Felix7635/BA-Dokumentation/Abbildungen.tex

% !TEX root = BA-Bauer.tex
\newpage
\addcontentsline{toc}{section}{Abbildungsverzeichnis}
\renewcommand{\listfigurename}{Abbildungsverzeichnis}
\listoffigures
