Felix7635/BA-Dokumentation/Hardware.tex

% !TEX root = BA-Bauer

\newpage
\section{Hardware}
In den folgenden Kapiteln wird auf die in dieser Arbeit verwendete Hardware eingegangen. Zunächst wird das grundlegende Pinzip der Schaltung erläutert. Daraufhin werden die Bestandteile bzw. Module im Einzelnen näher erläutert und deren Funktionsweise und Funktion in der Gesamtschaltung erklärt. Abschließend wird erläutert, wie die abstrakte Schaltung in ein Platinendesign überführt und wie diese in einem Gehäuse plaziert wird. Die Datenblätter der Hardwarekomponenten befinden sich im Anhang \ref{CD-Anhang}.
\input{Hardware/Schaltungsprinzip}
\input{Hardware/STM32F446ZE}
\input{Hardware/Treiberchip}
\input{Hardware/Encoder}
\input{Hardware/LCD}
\input{Hardware/LED}
\input{Hardware/Spannungsversorgung}
\input{Hardware/EAGLE}
\input{Hardware/Platinendesign}
\input{Hardware/Gehäusedesign}
%Formaterung überprüfen: Einige Bilder stehen nicht am richtigen Platz (durch Seitenumbruch)
