Felix7635/BA-Dokumentation/Hardware/Encoder.tex

% !TEX root = BA-Bauer

\subsection{Encoder}
\label{sec:Encoder}
Für die Benutzereingaben sind Taster und vor allem ein Encoder wichtig. Taster ermöglichen eine zeitlich präzise Eingabe, wohingegen ein Encoder viele Eingaben in kurzer Zeit ermöglicht. Möchte ein Benutzer eine Aufnahmezeit von 55 Sekunden einstellen, so müsste er 55 Mal einen Taster betätigen, mit einem Encoder reichen wenige Umdrehungen dafür aus. In diesem Kapitel wird auf das Funktionsprinzip und die Beschaltung des verwendeten Encoders eingegangen.\\
%Formulierung: Raster bei den Umdrehung ->24
Ein Encoder besteht im einfachsten Sinne aus zwei Schaltern, wie Abbildung \ref{fig:Encoder-Schaltung} zeigt. 
\begin{figure}[h]
	\begin{center}
		
		\caption{Encoder Schaltung \cite{EncoderMN}}
		\label{fig:Encoder-Schaltung}
	\end{center}
\end{figure}
Die Schalter sind auf der einen Seite intern miteinander verbunden (\textit{Terminal C}) und werden auf das 0\,V Potential geschaltet. Die andere Seite der Schalter wird direkt über \textit{Terminal A} und \textit{Terminal B} nach außen geführt. 
%Jeweils ein exerner 10\,k$\Omega$ Pull-Up-Widerstand (R1 und R3) zieht die Ausgänge auf die Betriebsspannug von 5\,V. Ist der Schalter geöffnet, so fließt kein Strom und folglich fällt keine Spannung am Pull-Up-Widerstand ab. Am entsprechenden Terminal können 5\,V gegenüber der Masse gemessen werden. Ist der Schalter geschlossen so fällt die gesamte Spannung am Widerstand ab und am entsprechenden Terminal liegt nun Masse-Potential an. 
Beide Terminals werden mit jeweils einem 10\,k$\Omega$ Pull-Up-Widerstand ($R1$ und $R2$) auf die Betriebsspannung von 5\,V gezogen. Gleichzeitig wird der Strom, der fließt wenn ein Schalter geschlossen ist, begrenzt. Der Hersteller des Encoders empfiehlt das Beschalten des Encoders mit zwei CR-Tiefpassfiltern, um hochfrequente Schaltvorgänge zu filtern. Bei einem Schaltvorgang können die Kontakte des Schalters mechanisch schwingen (Prellen) und dadurch mehrfach hintereinander öffnen und schließen \cite[S. 67]{TechInfo}, wodurch mehrfache Eingaben getätigt werden, obwohl der Encoder nur um einen Schritt gedreht wurde. Die Signale des Encoders werden an Punkt A und B in Abbildung \ref{fig:Encoder-Schaltung} entnommen und über zwei Leiterbahnen zum MCU geführt. Ist ein Schalter geöffnet, so wird die Kapazität des CR-Filters geladen und die an ihm abfallende Spannung erhöht sich bis zur Betriebsspannung von 5\,V. Wird der Schalter nun geschlossen, so entlädt sich der Kondensator in Richtung des entsprechenden Terminals. Die Spannung an der Kapazität sinkt bis zum 0\,V-Potential. Fängt ein Schalter an zu schwingen, reicht die Zeit zum Laden bzw. Entladen der Kapazität nicht aus, um eine Pegeländerung zu erzielen. 
\begin{figure}[h]
	
	\caption{Encoder-Signal bei Drehung im Uhrzeigersinn}
	\label{fig:Encoder-signal}
\end{figure}
Wenn der Encoder gedreht wird, schließen und öffnen die internen Schalter versetzt zueinander. Abbildung \ref{fig:Encoder-signal} zeigt die ausgehenden Signale \textit{A} und \textit{B} im zeitlichen Verlauf bei einer gleichmäßigen Rotationsgeschwindigkeit. Durch den versetzten Rhythmus der beiden Schalter kann die Drehrichtung bestimmt werden, indem eines der beiden Signale betrachtet wird, in diesem Beispiel Signal \textit{A}. Ändert sich der Zustand des Signals von \textit{high} auf \textit{low}, kann zunächst bestimmt werden, dass eine Drehbewegung stattgefunden hat. Ist nun der Pegel des anderen Signals \textit{high}, so handelt es sich um eine gegen den Uhrzeigersinn drehende Bewegung. Ist das Signal \textit{low}, so handelt es sich um eine mit dem Uhrzeigersinn drehende Bewegung. Die einzelnen Schritte der Schalter sind haptisch für den Benutzer wahrnehmbar. Jeweils an den Stellen, an denen sich die Pegel beider $Terminals$ im high-Zustand befinden, rastet der Drehregler leicht ein. Dadurch wird sichergestellt, dass sich die Signale des Encoders während der Nichtbenutzung in einem stabilen Zustand befinden. Zudem ergibt sich daraus eine zusätzliche Rückmeldung an den Benutzer während der Eingabe.\\
%-Bewusst gegen Druckknopf entschieden, da zweiter Bestätigungsknopf zur Verwirrung des Benutzers führen kann\\
