Felix7635/BA-Dokumentation/GegenstandundZiel.tex

% !TEX root = BA-Bauer

\newpage
\section{Ziel der Arbeit}
\label{sec:Ziel}
In dieser Arbeit werden die in der vorangegangenen Praxisprojektarbeit erarbeiteten Funktionsprinzipien für die Aufnahme und Wiedergabe von DMX-Daten mit einem Mikrocontroller weiterentwickelt und in ein für den Endbenutzer ausgerichtetes Gerät implementiert. Ziel dabei ist die Entwicklung und Herstellung eines Prototypen eines DMX-Aufnahme- und -Wiedergabegerätes. Die Entwicklung ist auf das zukünftige Erlangen der Marktreife ausgerichtet. Zusätzlich zu den Inhalten der Praxisprojektarbeit wird eine umfassende Benutzerschnittstelle entwickelt. Diese ermöglicht dem Benutzer die Bedienung des Geräts ohne spezielle Vorkenntnisse. Konkret werden Taster und Drehgeber für die Eingaben des Benutzers, sowie ein Display und LEDs für Rückmeldungen an den Benutzer verwendet. Durch die Zunahme an Funktionalität und der Anzahl der Komponenten wird außerdem die elektrische Schaltung der Praxisprojektarbeit dementsprechend erweitert und an bereits vorhandenen Stellen optimiert. Für die erweiterte Schaltung wird eine Platine entwickelt, hergestellt und bestückt. Zudem wird ein passendes, kompaktes Gehäuse für die Platine gestaltet und hergestellt.\\
Für die neu hinzugekommene Benutzerschnittstelle sind nicht nur die Komponenten wichtig, sondern auch die Software, die sie steuert. Dafür wird entsprechender Programmcode entwickelt, der dem Benutzer sinnvolle und auswertbare Rückmeldungen gibt und ihm eine intuitive Bedienung des Gerätes ermöglicht. Der Benutzer soll außerdem die Möglichkeit haben, gewisse Einstellungen vorzunehmen um die Funktion des Gerätes auf die eigenen Bedürfnisse anzupassen. Ein besonderes Augenmerk liegt auf der Optimierung der Aufnahme, Wiedergabe und Speicherung der DMX-Daten. Auch hier sollen dem Benutzer möglichst viele Freiheiten eingeräumt werden. Die in der Praxisprojektarbeit erarbeiteten Grundlagen werden dafür verwendet, erweitert und optimiert. Zudem werden die Optimierungsvorschläge der Praxisprojektarbeit berücksichtigt und zum Teil umgesetzt. Für die Entwicklung des Gerätes sind folgende Haupt- und Nebenanforderungen definiert.\\
\newline
\textbf{Hauptanforderungen:}\\
- Möglichkeit mehrere Aufnahmen anzulegen\\
- Einstellbare Aufnahmezeit\\
- Aufname eines DMX-Stroms und einzelner DMX-Datenpakete\\
- Benutzerschnittstelle mit Display und Menüführung\\
- Maßgeschneidertes Platinendesign\\
- Gehäuse\\
- Handliche Größe\\
\newline
\textbf{Nebenanforderungen:}\\
- Intuitive Benutzerschnittstelle\\
- Optisch Ansprechendes Design des Gehäuses\\
- Optimierung des Speicherbedarfs auf der SD-Karte\\
- Möglichkeit die Wiedergabegeschwindigkeit während der aktiven Wiedergabe zu ändern\\
