Felix7635/BA-Dokumentation/Gender.tex

% !TEX root = BA-Bauer.tex
\newpage
\noindent\begin{minipage}[c][.99\textheight][c]{\textwidth}
	\centering
	\begin{minipage}{.65\linewidth}
		%\centering
		\textbf{Gender Erklärung}\\
		\newline
		%\vspace{.5cm}
		Aus Gründen der besseren Lesbarkeit wird in dieser Bachelor-abschlussarbeit das generische Maskulin verwendet. Dabei sind weibliche und anderweitige Identitäten des Geschlechts ausdrücklich gleichermaßen gemeint.
	\end{minipage}
\end{minipage}
