Felix7635/BA-Dokumentation/BA-Bauer.tex

\documentclass[12p, a4paper]{article}

\usepackage[headsepline, footsepline]{scrlayer-scrpage}
\usepackage[hidelinks]{hyperref}

\pagestyle{scrheadings}
\ihead{Bachelorabschlussarbeit}
\ohead{\headmark}
\automark{section}
\ifoot{Felix Bauer}
\ofoot{\pagemark}
\setlength{\tabcolsep}{10pt}
\renewcommand{\arraystretch}{1.5}

\usepackage{listings}
\lstset{numbers = left, numberstyle = \tiny, numbersep = 5pt, language = C, keywordstyle = \color{blue}, stringstyle = \color{teal}, commentstyle = \color{gray}, morecomment = [l][\color{orange}]{\#}, caption={\protect\filename@parse{\lstname}\protect\filename@base\\.\protect\filename@ext},
basicstyle=\sffamily}
\renewcommand{\lstlistingname}{Codeausschnitt}
\usepackage{pdfpages}
\usepackage[ngerman]{babel}
\usepackage[utf8]{inputenc}
\usepackage[top = 25mm, bottom = 20mm, left = 25mm, right = 25mm]{geometry}
\usepackage[onehalfspacing]{setspace}
\usepackage{graphicx}
\graphicspath{{./images/}}
\usepackage{acronym}

\begin{document}
	\input{Titelblatt}
	\input{Selbstständigkeitserklärung}
	\input{Gender}
	\input{Inhaltsverzeichnis}
	\input{Abkürzungsverzeichnis}
	\input{Einleitung}
	\input{GegenstandundZiel}
	\input{Hardware}
	\input{Software}
	\input{Zusammenfassung}
	\input{Danksagung}
	\input{Literatur}
	\input{Abbildungen}
	\input{Codeausschnitt}
	\input{Anhang}

\end{document}
