Felix7635/BA-Dokumentation/Abkürzungsverzeichnis.tex

% !TEX root = BA-Bauer.tex
\newpage
\section*{Abkürzungsverzeichnis}
\addcontentsline{toc}{section}{Abkürzungsverzeichnis}
\begin{acronym}[main]
	\acro{CAD}[CAD]{Computer Aided Design}
	\acro{CCR}[CCR]{Capture Compare Register}
	\acro{DCP}[DCP]{Dedicated Charging Port}
	\acro{DR}[DR]{Data Register}
	\acro{DMX}[DMX]{Digital Multiplexing}
	\acro{EDA}[EDA]{Electronic Design Automation}
	\acro{FAT}[FAT]{File Allocation Table}
	\acro{FATFS}[FATFS]{FAT- Filesystem}
	\acro{HAL}[HAL]{Hardware Abstraction Layer}
	\acro{HSE}[HSE]{High Speed External}
	\acro{HSI}[HSI]{High Speed Internal}
	\acro{LCD}[LCD]{Liquid-Crystal-Display}
	\acro{LED}[LED]{Light Emitting Diode}
	\acro{LDO}[LDO]{Linear Dropout}
	\acro{MCU}[MCU]{Microcontroller Unit}
	\acro{PLL}[PLL]{Phase Locked Loop}
	\acro{SD}[SD]{Secure Digital}
	\acro{SMT}[SMT]{Surface Mount Technology}
	\acro{SR}[SR]{Status Register}
	\acro{SWD}[SWD]{Serial Wire Debug}
	\acro{THT}[THT]{Through Hole Technology}
	\acro{UI}[UI]{User Interface}
	\acro{USB}[USB]{Universal Serial Bus}
\end{acronym}
