Felix7635/BA-Dokumentation/Entwicklungsschritte.tex

% !TEX root = BA-Bauer

\newpage
\section{(Entwicklungsschritte)}

-Grundlegendes Konzept (Weiterentwicklung der BPA)\\
-Schaltung und Komponentensuche\\
-Boarddesign\\
-Prototyfertigung\\
-Bestellung (Platine und Komponenten)\\
-Während Lieferung Softwaredesign\\
-Einzelne Komponenten zum laufen kriegen\\
-Gehäusedesign\\
