Felix7635/BA-Dokumentation/Titelblatt.tex

% !TEX root=BA-Bauer.tex

\begin{titlepage}
	\begin{center}
		\Huge
		\vspace*{2cm}
		\textbf{Entwicklung eines Aufnahme- und Wiedergabegerätes für DMX-Daten}
		
		\Large
		\vspace{2cm}
		Bachelorabschlussarbeit\\
		\vspace{.5cm}
		von\\
		\vspace{.5cm}
		Felix Bauer\\
		\vspace{1cm}
		Im Studiengang B.Eng Elektrotechnik/Informationstechnik\\ mit Schwerpunkt Mess- und Automatisierungstechnik\\
		\vspace{.5cm}
		an der HAWK Hochschule für angewandte Wissenschaft und Kunst\\ Hildesheim/Holzminden/Göttingen\\ Fakultät Ingenieurwissenschaften und Gesundheit in Göttingen\\
		\vspace{1.5cm}
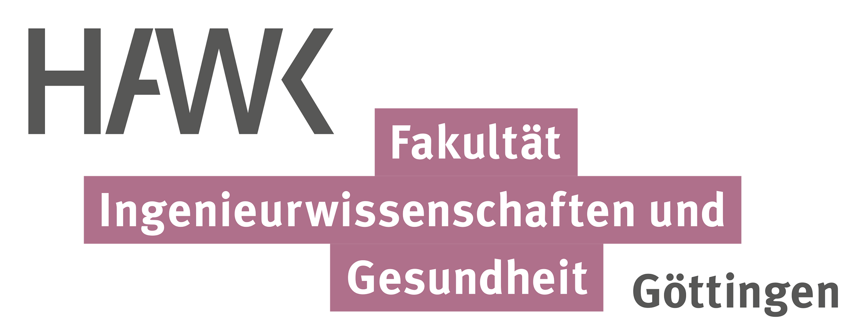
[picture p1: images/HAWK-Logo.png]
		\\
		\vspace{1.5cm}
		Erstprüfer: Prof. Dr. rer. nat. Roman Grothausmann\\
		Zweitprüfer: Dipl.-Ing. Tobias Bürmann\\
		\vspace{.5cm}
		\today
		
		\vfill
	\end{center}
\end{titlepage}
