Felix7635/BA-Dokumentation/Software/Menü.tex

% !TEX root = BA-Bauer.tex
\subsection{Menü}
Die Menüführung ist ein essentieller Bestandteil für die intuitive Bedienbarkeit des Gerätes. Sie muss leicht für den Benutzer zu durchschauen sein und mit den begrenzten Möglichkeiten der C-Programmiersprache programmierbar sein. Für die Menüführung wird ein einfaches Modell aus mehreren Ebenen verwendet. Nachdem das Gerät gestartet und alle Schnittstellen initialisiert sind, wird das Hauptmenü auf dem LCD angezeigt. Der Inhalt des Displays ist in Abbildung \ref{fig:lcdmain} zu sehen. 
\begin{figure}[h]
	\begin{minipage}{.22\linewidth}
		\centering
		
		\caption{LCD-Hauptmenü}
		\label{fig:lcdmain}
	\end{minipage}
	\hfill
	\begin{minipage}{.22\linewidth}
		\centering
		
		\caption{LCD-Aufnahme}
		\label{fig:lcdrec}
	\end{minipage}
	\hfill
	\begin{minipage}{.22\linewidth}
		\centering
		
		\caption{LCD-Wiedergabe}
		\label{fig:lcdplay}
	\end{minipage}
	\hfill
	\begin{minipage}{.22\linewidth}
		\centering
		
		\caption{LCD-Einstellungen}
		\label{fig:lcdset}
	\end{minipage}
\end{figure}
Das Hauptmenü stellt Ebene 0, also die unterste Ebene des Menüs, dar. Zu Beginn ist der erste Menüeintrag gewählt und wird mit einem Pfeil in der ersten Spalte des LCDs markiert. Durch drehen des Encoders kann der Pfeil und damit der ausgewählte Eintrag verändert werden. Eine Drehung im Uhrzeigersinn verschiebt die Auswahl nach unten, eine Drehung gegen den Uhrzeigersinn nach oben. Ist die auszuführende Funktion mithilfe des Pfeils ausgewählt, so kann mit der Betätigung des Bestätigungs-Tasters die nächste Ebene des Menüs erreicht werden. Mithilfe des Zurück-Tasters kann zu der vorherigen Ebene zurückgekehrt werden. Je nach Auswahl werden die Inhalte aus Abbildung \ref{fig:lcdplay}, \ref{fig:lcdrec} oder \ref{fig:lcdset} angezeigt. Da auf dem LCD lediglich vier Zeilen für die Anzeige zur Verfügung stehen, sind Abbildung \ref{fig:lcdrec} und \ref{fig:lcdset} um die nicht sichtbaren Zeilen gestreckt.
In Ebene 3 des Menüs befinden sich die tatsächlichen Funktionen zur Aufnahme und Wiedergabe der DMX-Daten und den Einstellungen. Im Hauptprogramm wird lediglich die Funktion $main\_menu(...)$ aufgerufen, um das Hauptmenü anzuzeigen. Die Zeichenketten, welche über das LCD ausgegeben werden, sind in mehrdimensionalen $char$-Arrays definiert (Codeausschnitt \ref{code:menuarray}).
\lstinputlisting[firstline = 13, firstnumber = 13, lastline = 18, language = C, caption =menu.c: Definition Zeichenkettenarray für LCD-Ausgaben, label = code:menuarray]{/Users/Felix/Documents/CubeMX/BPA-Code/Core/Src/menu.c}
Die erste Dimension des Arrays entspricht der Anzahl der anzuzeigenden Menüelemente, die zweite der Anzahl der zu beschreibenden Spalten des LCDs. Es werden bewusst nur 19 Spalten der verfügbaren 20 mit den Menüelementen beschrieben, da vor jedem Element Platz für den Pfeil freigehalten wird, der die aktuelle Auswahl anzeigt. Um willkürliche Zeichen zu eliminieren, die sich eventuell noch in den nicht beschriebenen Speicherzellen der Arrays befinden, werden die nicht benötigten Zeichen mit Leerzeichen überschrieben. Durch die Verwendung der Zeichenkettenarrays können die Menüeinträge einfach verändert oder erweitert werden. 
\begin{figure}[h!]
	\centering
	
	\caption{Flussdiagramm Hauptmenü}
	\label{fig:flusshauptmenu}
\end{figure}
Abbildung \ref{fig:flusshauptmenu} zeigt den Ablauf der Funktion $main\_menu(...)$. Zunächst werden alle Inhalte vom Display entfernt und die Menüüberschrift ausgegeben. Die globale Variable der Position des Encoders wird auf den Initialwert 0 zurückgesetzt. Daraufhin werden die ersten drei Menüeinträge aus dem Zeichenkettenarray unterhalb der Menüüberschrift ausgegeben (Abbildung \ref{fig:lcdmain}). Der Wert der Encoderposition entspricht der aktuellen Auswahl des Benutzers. Initial gilt der erste Eintrag als ausgewählt. Um nicht bei jedem Durchlauf der Funktion den gesamten Displayinhalt erneut ausgeben zu müssen erfolgt eine Abfrage ob sich die Encoderposition geändert hat. Nur wenn er sich verändert hat, wird der Auswahlpfeil an der entsprechend resultierenden Stelle angezeigt. Ist der Enter-Taster betätigt, wird die nächste entsprechende Menüebene aufgerufen. Welche Menüfunktion aufgerufen wird, wird mithilfe einer $switch-case$-Anweisung der Encoderposition entschieden. 
\newline
Um zu einer vorherigen Menüebene zurückzukehren, müssen die Menüfunktionen durch einen $return$-Befehl oder durch Erreichen des Endes der Funktion beendet werden. Werden die vorherigen Menüebenen in der jeweiligen Funktion durch einen Funktionsaufruf aufgerufen, kommt es zu einem rekursiven Aufruf von Funktionen. Zwangsläufig entstehen daraus Speicherprobleme, da reservierter Speicherplatz durch den Aufruf der Funktionen nicht wieder freigegeben wird. Ist der Speicher voll, so kommt es bei einem nächsten Funktionsaufruf zum Überlauf des Speichers und dadurch zu Fehlfunktionen oder vollständigem Abbruch des Programms.
