Felix7635/BA-Dokumentation/Software/SD.tex

% !TEX root = BA-Bauer.tex

\subsection{SD-Karte (SDIO-Schnittstelle)}

Die von CubeMX generierte Initialisierungs-Funktion der \textit{secure digital input output} (SDIO)-Schnittstelle führt beim Start des Gerätes oft zu Fehlern, wodurch die SD-Karte weder gelesen noch beschrieben werden kann. In der Regel fällt das Programm dann in eine endlose Fehler-Funktion und ein Neustart des Geräts bewirkt keine Änderung des Zustands. Um dieses Problem zu lösen, wird nach den von CubeMX generierten Initialisierungsfunktionen im Hauptprogramm eine weitere Funktion zur Initialisierung der Verbindung mit der SD-Karte aufgerufen. Der wesentliche Inhalt dieser Funktion ist in Codeausschnitt \ref{code:SDinit} zu sehen.
\lstinputlisting[
caption =main.c: SD Initialisierungs-Funktion,
label = code:SDinit,
firstline = 284,
firstnumber = 284,
lastline = 295]
{/Users/Felix/Documents/CubeMX/BPA-Code/Core/Src/main.c}
Um eine SD-Karte verwenden zu können, muss diese als erstes mithilfe der Funktion $f\_mount(...)$ montiert werden. Dabei wird ein Dateisystem ($filesystem$) und ein Pfad ($path$) mit der Hardware verknüpft. Bei diesem Schritt treten in der Regel Fehler auf. Ist der Rückgabewert der Funktion $f\_mount(...)$ nicht $FR\_OK$ werden die Zeilen 285 bis 294 so lange wiederholt, bis die SD-Karte erfolgreich montiert ist, denn ohne ein Speichermedium ist das Gerät in keinerlei Hinsicht sinnvoll verwendbar. Der aktuelle Status der SD-Karte wird als erstes der Variable $sd\_state$ zugewiesen. Befindet sich keine SD-Karte im SD-Kartenslot ($STA\_NODISK$) wird eine entsprechende Meldung über das LCD an den Benutzer gegeben. Ist der Status der SD-Karte $STA\_NOINIT$, so wird das Montieren der SD-Karte zunächst rückgängig gemacht, indem erneut die Funktion $f\_mount(...)$ aufgerufen wird, jedoch wird der Wert 0 als Dateisystem-Übergabeparameter der Funktion übergeben. Daraufhin wird die Variable des Dateisystem mithilfe der $memset(...)$ Funktion mit 0 initialisiert und eine erneute SD-Initialisierung gestartet. Zuletzt wird der Pfad mithilfe der Funktion $SD\_initialize(...)$ erneut initialisiert. Die Schleife startet erneut mit einem weiteren Versuch der Montierung.
\newline
Codeausschnitt \ref{code:SDread} zeigt einen beispielhaften Ablauf eines Lesevorgangs von der SD-Karte. Der Vorgang startet mit dem Öffnen einer Datei ($File$), zu sehen in Zeile 1009. Mit dem Parameter $FA\_READ$ wird der Funktion mitgeteilt, dass die Datei gelesen werden soll. Der Parameter $FA\_OPEN\_ALWAYS$ sorgt dafür, dass die Datei geöffnet wird wenn sie existiert, ansonsten wird eine Datei mit dem entsprechenden Dateinamen ($hdmx->DMXInfoFile\_name$) erstellt. In dem gezeigten Beispiel wird von der Existenz der Datei ausgegangen. Mit dem Parameter $FA\_OPEN\_EXISTING$ wird eine bereits existierende Datei geöffnet. Falls sie nicht existiert, gibt die Funktion einen entsprechenden Fehlercode zurück. Soll eine Datei beschrieben werden, muss der Parameter $FA\_WRITE$ übergeben werden.
\lstinputlisting[
caption =DMX.c: Beispiel Lesevorgang der SD-karte,
label = code:SDread,
firstline = 1009,
firstnumber = 1009,
lastline = 1016]
{/Users/Felix/Documents/CubeMX/BPA-Code/Core/Src/DMX.c}
Nachdem die Datei geöffnet ist, werden Daten mit der Funktion $f\_read(...)$ aus der Datei gelesen. Der erste Übergabeparameter ($File$) ist das Objekt der Datei, aus der gelesen werden soll. Darauf folgt die Adresse der Zielvariable, in der die gelesenen Daten gespeichert werden sollen. An dritter Stelle steht die Anzahl der zu lesenden Bytes. Der letzte Übergabeparameter ist die Adresse einer Variable, in der die Anzahl der tatsächlich gelesenen Bytes gespeichert wird. Durch einen nachfolgenden Vergleich der Soll- und Ist-Anzahl der gelesenen Bytes können Fehler, die beim Lesevorgang aufgetreten sind, identifiziert werden \cite{FATFS}. Nachdem alle Lesevorgänge beendet sind, muss die Datei mit der Funktion $f\_close(...)$ wieder geschlossen werden, da die Anzahl der gleichzeitig geöffneten Dateien begrenzt ist, um Speicherprobleme auszuschließen.\\
\newline
\textbf{Optimierungsmöglichkeiten}\\
In der aktuellen Version des Programms wird der 1-Bit-Modus der SDIO-Schnittstelle verwendet. Von den vier vorhandenen Datenleitungen wird nur eine in diesem Modus verwendet. Auf der Platine sind zusätzliche Leiterbahnen für die Verwendung eines 4-Bit-Modus vorhanden. Scheinbar befinden sich Fehler in der SDIO-Bibliothek in CubeMX, wodurch der Montierungs-Vorgang nicht erfolgreich durchgeführt werden kann. Durch die Verwendung des 4-Bit-Modus könnte die Lese- und Schreibgeschwindigkeit der SD-Karte im bestmöglichen Fall vervierfacht werden und trägt damit zur Stabilität während der Aufnahme und Wiedergabe bei.
