Felix7635/BA-Dokumentation/Software/Aufnahmefunktion.tex

% !TEX root = BA-Bauer.tex

\subsection{Aufnahmefunktionen}
\label{sec:recfunctions}
Für die Aufnahme von DMX-Daten stehen insgesamt vier verschiedene Aufnahmemodi zur Verfügung, welche jeweils eine Aufnahmefunktion bilden. Der erste Aufnahmemodus ist der Standard-Modus, bei dem vorab die Dauer der Aufnahme festgelegt wird. Nach Ablauf der Aufnahmedauer stoppt die Aufnahme und kehrt zum Menü zurück. Der zweite Modus ist der sogenannte $Trigger$-Modus, bei dem zuvor in den Einstellungen ein $Trigger$-Kanal und $Trigger$-Wert festgelegt werden. Ist die Aufnahme gestartet und in den eingehenden DMX-Datenpaketen wird der $Trigger$-Wert des ausgewählten $Trigger$-Kanals überschritten, so startet ab diesem Zeitpunkt die Speicherung der DMX-Daten. Die Aufnahme wird gestoppt, wenn der $Trigger$-Wert wieder unterschritten wird. Dieser Modus ermöglicht das Starten und Stoppen der Aufnahme zu sehr präzisen Zeitpunkten. Vor allem für sich wiederholende Bewegungsabläufe von lichttechnischen Geräten ist diese Funktion äußerst sinnvoll. Ist die Position eines Lichtkegels beispielsweise am Anfang und Ende der Aufnahme identisch, so kann die Aufnahme endlos nacheinander wiedergegeben werden, ohne dass ein Anfang oder Ende der aufgenommenen Sequenz sichtbar ist. Der letzte kontinuierliche Aufnahme-Typ ist die endlose Aufnahme, bei der die Aufnahme ohne die Wahl einer Aufnahmedauer gestartet wird und durch betätigen des Zurück-Tasters gestoppt wird. Dieser Modus richtet sich an Situationen, in denen die Endzeit der Aufnahme beim Aufnahmebeginn nicht festgelegt werden kann. Ein Beispiel für einen Anwendungsfall ist ein Konzert. Zu Beginn des Konzerts kann die Aufnahme gestartet und nach der letzten Zugabe, gestoppt werden. Bei dem letzten Aufnahme-Typ handelt es sich um eine nicht-kontinuierliche Aufnahme der DMX-Daten, die sogenannte $Step$-Aufnahme. Bei diesem Aufnahme-Typ können einzelne Datenpakete des eingehenden DMX-Datenstroms aufgenommen werden. Jedes Datenpaket entspricht einem $Step$ und enthält, im Gegensatz zu den drei anderen Aufnahmemodi, keine Zeitinformationen. Die einzelnen Steps werden bei der Wiedergabe in einem regelmäßigen Zeitabstand, der erst bei der Wiedergabe vom Benutzer festgelegt wird, wiedergegeben. Dieser Modus gibt dem Benutzer die Möglichkeit die DMX-Datenpakete in einer bestimmten Taktung auszugeben und diese beispielsweise an den Takt eines Liedes anzupassen. Zudem wird durch die Speicherung einzelner Datenpakete, im Vergleich zu den anderen Aufnahmemodi, deutlich weniger Speicherplatz auf der SD-Karte benötigt. 
Im Folgenden wird auf das Grundprinzip der Aufnahmefunktionen eingegangen. Ein Flussdiagramm des Standard-Aufnahmemodus befindet sich im Anhang \ref{fluss:recf}.\newline
Die drei Aufnahmemodi der kontinuierlichen Aufnahme, also Standard-, Endlose- und $Trigger$-Aufnahme unterscheiden sich im wesentlichen nur in den Start- bzw. Stoppbedingungen, welche in Tabelle \ref{tab:recstartstop} zusammengefasst sind. Im Standardmodus muss zusätzlich eine Aufnahmezeit festgelegt werden. 
\begin{table}[h]
	\begin{center}
		\caption{Start und Stoppbedingungen der Aufnahmemodi}
		\label{tab:recstartstop}
		\begin{tabular}{l | p{6cm} | p{6cm}}
			Modus & Startbedingung & Stoppbedingung\\
			\hline
			Standard & Bestätigungstaster & Ablauf der Aufnahmezeit\\
			Endlos & Bestätigungstaster & Zurück-Taster\\
			$Trigger$ & $Trigger$-Wert auf $Trigger$-Kanal überschreiten & $Trigger$-Wert auf $Trigger$-Kanal unterschreiten
		\end{tabular}
	\end{center}
\end{table}\newline
\subsubsection{Festlegen der Aufnahmezeit}
Abbildung \ref{lcd:rectime} zeigt die Ausgabe auf dem LCD für die Festlegung der Aufnahmezeit. Die Auswahl der Zeit ist in vier Blöcke für das Einstellen der Stunden, Minuten, Sekunden und Millisekunden aufgeteilt. Mit den Links- und Rechts-Tastern kann der ausgewählte Block, markiert mit dem Zeichen in der untersten Zeile des Displays, verändert werden. 
\begin{figure}[h]
	\begin{center}
		
		\caption{LCD-Ausgabe Aufnahmezeit}
		\label{lcd:rectime}
	\end{center}
\end{figure}
Der Wert des Blocks wird mit einer Drehung des Encoders im Uhrzeigersinn erhöht und gegen den Uhrzeigersinn verringert. Der Millisekunden-Block erhöht bzw. verringert sich immer um 10 Millisekunden. Eine feinere Auflösung im Millisekundenbereich ist nicht sinnvoll, da die DMX-Datenpakete eine Zeitdauer von 22\,ms zur vollständigen Übertragung benötigen. Wird eine Drehbewegung des Encoders registriert, so wird zunächst überprüft ob der vorherige Wert weiter erhöht oder verringert werden kann. Damit wird ausgeschlossen, dass eine Zeit kleiner null gewählt werden kann oder beispielsweise die Anzahl der Minuten größer 59 ist. Ist die Auswahl der Zeit beendet, so muss sie mit dem Bestätigung-Taster bestätigt werden. Die eingegebene Zeit wird dann in Millisekunden umgerechnet und in die entsprechende Variable der Aufnahmezeit geschrieben.\\
\newline
\textbf{Optimierungsmöglichkeiten}\\
Um die Festlegung der Aufnahmezeit noch benutzerfreundlicher zu gestalten, ist es sinnvoll die Begrenzungen der einstellbaren Zeit aufzuheben. Sind zum Beispiel 59\,Sekunden eingestellt und der Wert wird mit einer Drehung des Encoder weiter erhöht, so wäre es sinnvoll die Anzahl der Minuten zu inkrementieren und die Anzahl der Sekunden auf null zurückzusetzen. Das gleiche Prinzip könnte auch in die andere Richtung funktionieren. Außerdem ist bei der Festlegung der Zeit die maximal mögliche Aufnahmedauer nicht berücksichtigt. Der Benutzer hätte also die Möglichkeit eine Aufnahmezeit festzulegen, die technisch aufgrund der maximalen Dateigröße auf der SD-Karte nicht erreicht werden kann. Dieser Fall sollte durch eine entsprechende Abfrage abgefangen werden.
\subsubsection{Festlegen des Dateinamens}
Jede Aufnahme erfordert die Festlegung eines Dateinamens, um eine Auswahl bei der Wiedergabe zu ermöglichen. Der vor der Aufnahme festgelegte Name entspricht dem Dateinamen der Datei auf der SD-Karte und ermöglicht dem Benutzer ausgewählte Aufnahmen auf andere SD-Karten zu übertragen oder Sicherheitskopien anzulegen. Dem Benutzer stehen bei der Festlegung des Namens insgesamt acht Zeichen zur Verfügung. Abbildung \ref{lcd:filename} zeigt die Ausgabe auf dem LCD-Display. Wie bereits im vorherigen Kapitel wird mithilfe der Links- und Rechts-Taster eine Auswahl getroffen, in diesem Fall ein Zeichen des Dateinamens. Durch drehen des Encoders können die Zeichen geändert werden. Verfügbare Zeichen sind alle Buchstaben von A-Z in kleiner und großer Schreibweise, Zahlen von 0-9, sowie ein Leerzeichen und ein Unterstrich.
\begin{figure}[h]
	\begin{center}
		
		\caption{LCD-Ausgabe Dateinamen einstellen}
		\label{lcd:filename}
	\end{center}
\end{figure}
Umgesetzt wird dieser Programmteil mithilfe eines Zeichen-Arrays, dessen Anzahl an Zellen der Länge des Dateinamens entspricht. Die letzten vier Zellen des Arrays werden mit der Dateiendung ($.dmx$) beschrieben. Die Endung ist bei der Auswahl des Namens nicht veränderbar. Die restlichen Zellen des Arrays werden initial mit einem Unterstrich beschrieben und sollen damit dem Benutzer ein veränderbares Zeichen signalisieren. Ein Zeichen besteht aus einem Byte und kann somit 256 Werte annehmen, wobei jeder Wert einem Zeichen entspricht. Wird zum Beispiel der Wert, der einem $a$ entspricht, um 1 inkrementiert, so wird ein $b$ dargestellt. Aufgrund dieses Systems kann der Wert der Position des Encoder unmittelbar als Zeichen dargestellt werden und in die entsprechende Zelle des Arrays geschrieben werden. Eine Veränderung der Encoderposition bewirkt eine Änderung des gerade ausgewählten Zeichens.
\input{Software/DMX-In}
\subsubsection{Speicherung der Aufnahmedaten}
\label{sec:save_data}
Abbildung \ref{fig:DMXDatenformat} zeigt die Reihenfolge, in der die einzelnen Bytes in der Aufnahme-Datei mit der Endung $.dmx$ gespeichert werden. Alle aufgenommenen Datenpakete werden hintereinander in der Datei gespeichert. Begonnen wird mit dem Zeitpunkt, an dem das Datenpaket vollständig empfangen wurde. Alle vier Bytes der 32-Bit Variable werden hintereinander gespeichert. Darauf folgen die eigentlichen DMX-Informationen der einzelnen DMX-Kanäle. Auch diese werden nacheinander gespeichert, beginnend mit dem DMX-Startbyte (Kanal 0). Nach dem letzten Datenbyte des DMX-Datenpaketes befindet sich das Schlusszeichen (NPC) des Datenpaketes. Direkt nach dem Schlusszeichen beginnt das nächste Datenpaket. 
\begin{figure}[h]
	\begin{center}
		
		\caption{DMX-Aufnahmedaten Bytereihenfolge}
		\label{fig:DMXDatenformat}
	\end{center}
\end{figure} Geht man davon aus, dass die DMX-Datenpakete mit der maximal möglichen Frequenz von ca. 44,1\,Hz eingehen, so wird pro Minute ein Speicherplatz von:
\begin{equation}
	44,1\,Hz * 518\,Byte * 60\,s = 1370628\,Byte = 1,37\,MByte
\end{equation} auf der SD-Karte benötigt. Eine SD-Karte mit einer Kapazität von 32\,GByte bietet somit Speicherplatz für ca. 23346 Minuten Aufnahme. Das entspricht einer Aufnahmedauer von etwas über 16\,Tagen. Begrenzender Faktor der maximalen Dauer einer Aufnahme stellt das $FAT$-Dateisystem dar. Es stellt nur 4-Bytes für die Angabe der Dateigröße zur Verfügung und begrenzt damit die maximale Dateigröße auf 4\,GB \cite[s. 128]{BetriebssystemeKompakt}. Eine Datei umfasst demnach maximal $2^{32}\,Byte$. Das entspricht einer maximalen kontinuierlichen Aufnahmedauer von:
\begin{equation}
	tAufnahme_{max} = \frac{2^{32}\,Byte}{518\,Byte * 44,1\,Hz * 60\,\frac{s}{min} * 60\,\frac{min}{h}} = 55,227\,h
\end{equation}
Diese Dauer sollte in den meisten Fällen ausreichend sein und könnte nur erweitert werden, indem ein anderes Dateisystem verwendet wird oder beim Erreichen der maximalen Dateigröße die Speicherung der Daten in einer zweiten Datei fortgeführt wird. 
Zusätzlich zu den DMX-Daten werden generelle Informationen über die Aufnahme in einer separaten Datei mit der Endung $.nfo$ gespeichert. Alle Informationen werden unabhängig vom Aufnahmemodus gespeichert. Darunter befinden sich die Aufnahmedauer, die Anzahl der gespeicherten Datenpakete und das NPC-Byte.\\
\newline
\textbf{Optimierungsmöglichkeiten}\\
Die Datenpakete werden unabhängig vom Informationsgrad gespeichert, was unnötig viel Speicherplatz erfordert. Denkbar ist ein Vergleich des aktuell zu speichernden DMX-Datenpakets mit dem zuvor gespeicherten DMX-Datenpaket. Beinhaltet das zuvor gespeicherte DMX-Datenpaket die selben Informationen wie das aktuelle, so könnte die Speicherung des aktuellen Paketes übersprungen werden, da es keine neuen Informationen enthält. Dieser Vorgang benötigt allerdings Ressourcen um den Vergleich der Datenpakete vorzunehmen. Durch den Vergleich und das eventuelle Wegfallen von Speicherungsvorgängen könnten wiederum Ressourcen eingespart werden.
