Felix7635/BA-Dokumentation/Software.tex

% !TEX root = BA-Bauer
\newpage
\section{Software}
In diesem Kapitel werden die Funktionsweisen der wichtigsten Funktionen der Software erläutert, sowie die Hilfsmittel die zur Erstellung des Programmcodes verwendet werden, vorgestellt. Der vollständige Programmcode, sowie Projektdateien befinden sich im Anhang \ref{CD-Anhang}, sowie als git-repository \cite{git_bpa_code} und \cite{git_lcd} auf github.com.
\input{Software/HAL}
\input{Software/CubeMX}
\input{Software/CubeIDE}
\input{Software/Taster}
\input{Software/Encoder}
\input{Software/DMX-Struktur}
\input{Software/Aufnahmefunktion}
\input{Software/Wiedergabefunktion}
\input{Software/LCD}
\input{Software/SD}
\input{Software/Menü}
\input{Software/Einstellungen}
