Felix7635/BA-Dokumentation/Danksagung.tex

% !TEX root = BA-Bauer.tex
\newpage
\section*{Danksagung}
\addcontentsline{toc}{section}{Danksagung}
An dieser Stelle möchte ich allen danken, die mich im Entwicklungsprozess und der Anfertigung dieser Arbeit unterstützt haben.\\
\newline
Zuerst möchte ich mich bei Herrn Prof. Dr. rer. nat. Roman Grothausmann und Herrn Dipl.-Ing. Tobias Bürmann für die Betreuung meiner Bachelorabschlussarbeit bedanken. Durch Ihren Einsatz ist die Bearbeitung dieses Themas erst möglich geworden. Auch die zahlreichen Meetings haben mir wertvolle Anregungen in Bezug auf die Entwicklung gegeben.\\
\newline
Mein Dank gilt außerdem Herrn Stefan Ludwig und das Kollegium des Labors, die mich bei der Herstellung einer Prototyp-Platine unterstützt haben. Sie haben die Platinenfräse der HAWK an die Grenzen des Machbaren gebracht und mich damit in der Entwicklung einen großen Schritt vorangebracht.\\
\newline
Ich danke Jannik Schulz für die wiederkehrende technische Unterstützung im gesamten Entwicklungsprozess.\\
\newline
Ebenfalls bedanke ich mich bei Isabel Klink und Robert Hut, die mich jederzeit tatkräftig mit ihrer Hilfsbereitschaft und Geduld unterstützt und motiviert haben.\\
\newline
Abschließend möchte ich mich bei den Korrekturlesende Isabel Klink, Jannik Schulz, Marcel Trebing und David Wendel bedanken.\\
\newline
Felix Bauer\\
\newline
\newline
\newline
Göttingen, 14.09.2021
