Felix7635/BA-Dokumentation/Anhang.tex

% !TEX root = BA-Bauer.tex

\newpage
\appendix
\section{Flussdiagramme}
\subsection{Aufnahmefunktion}
\label{fluss:recf}
\begin{figure}[h]
	\begin{center}
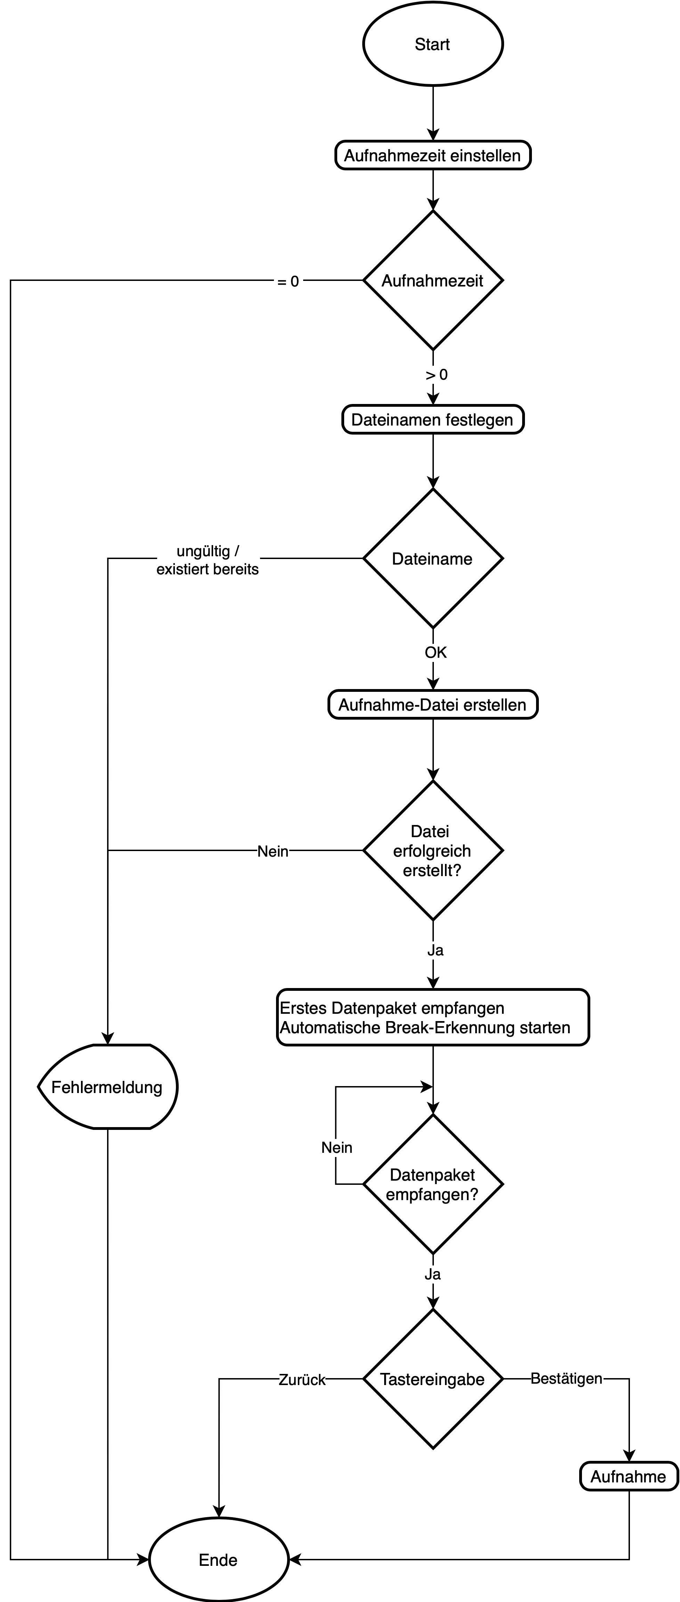
[picture p4: images/Aufnahmefunktion.png]
		
	\end{center}
\end{figure}
\newpage
\subsection{Wiedergabefunktion}
\label{fluss:playf}
\begin{figure}[h]
	\begin{center}
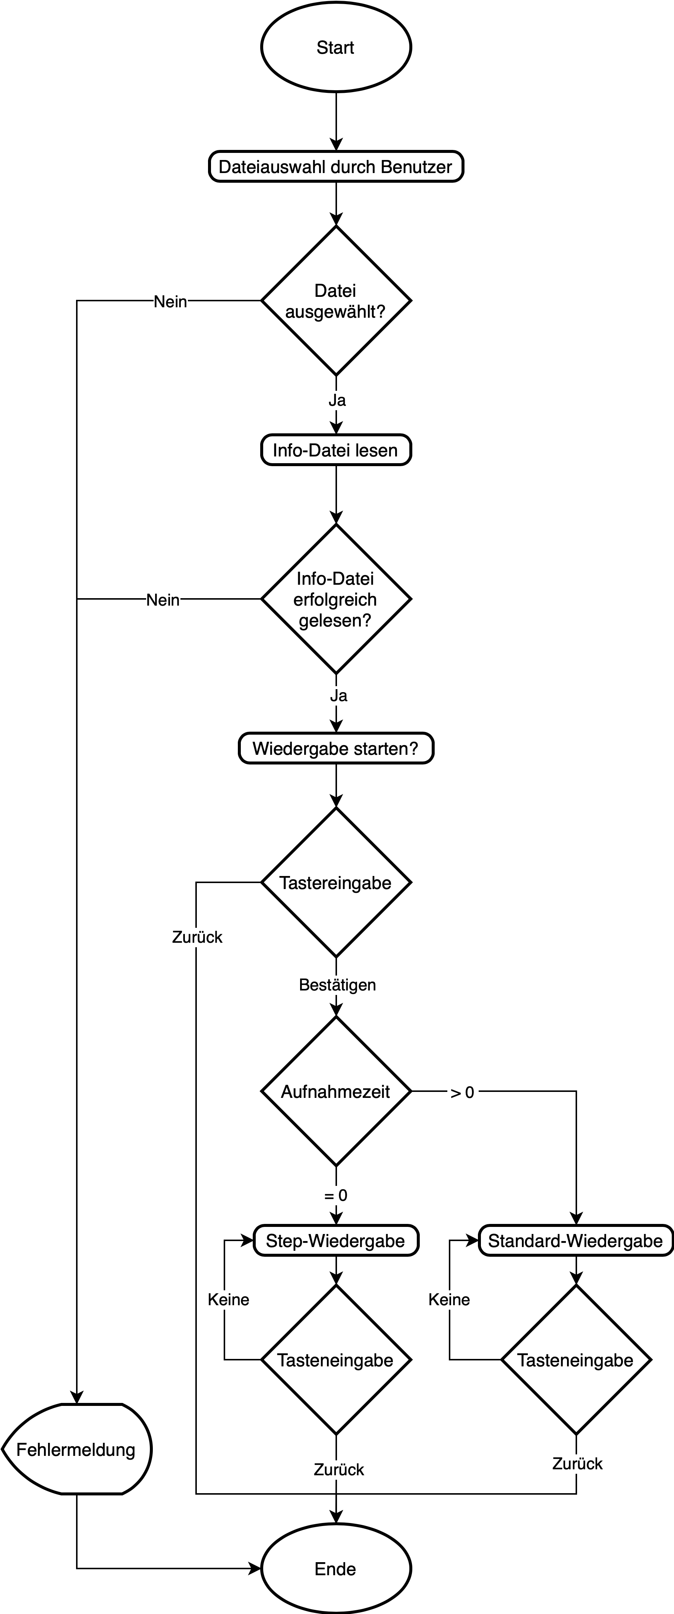
[picture p5: images/Wiedergabefunktion.png]
		
	\end{center}
\end{figure}
\newpage
\subsection{Standard Wiedergabe}
\label{fluss:playconti}
\begin{figure}[h]
	\begin{center}
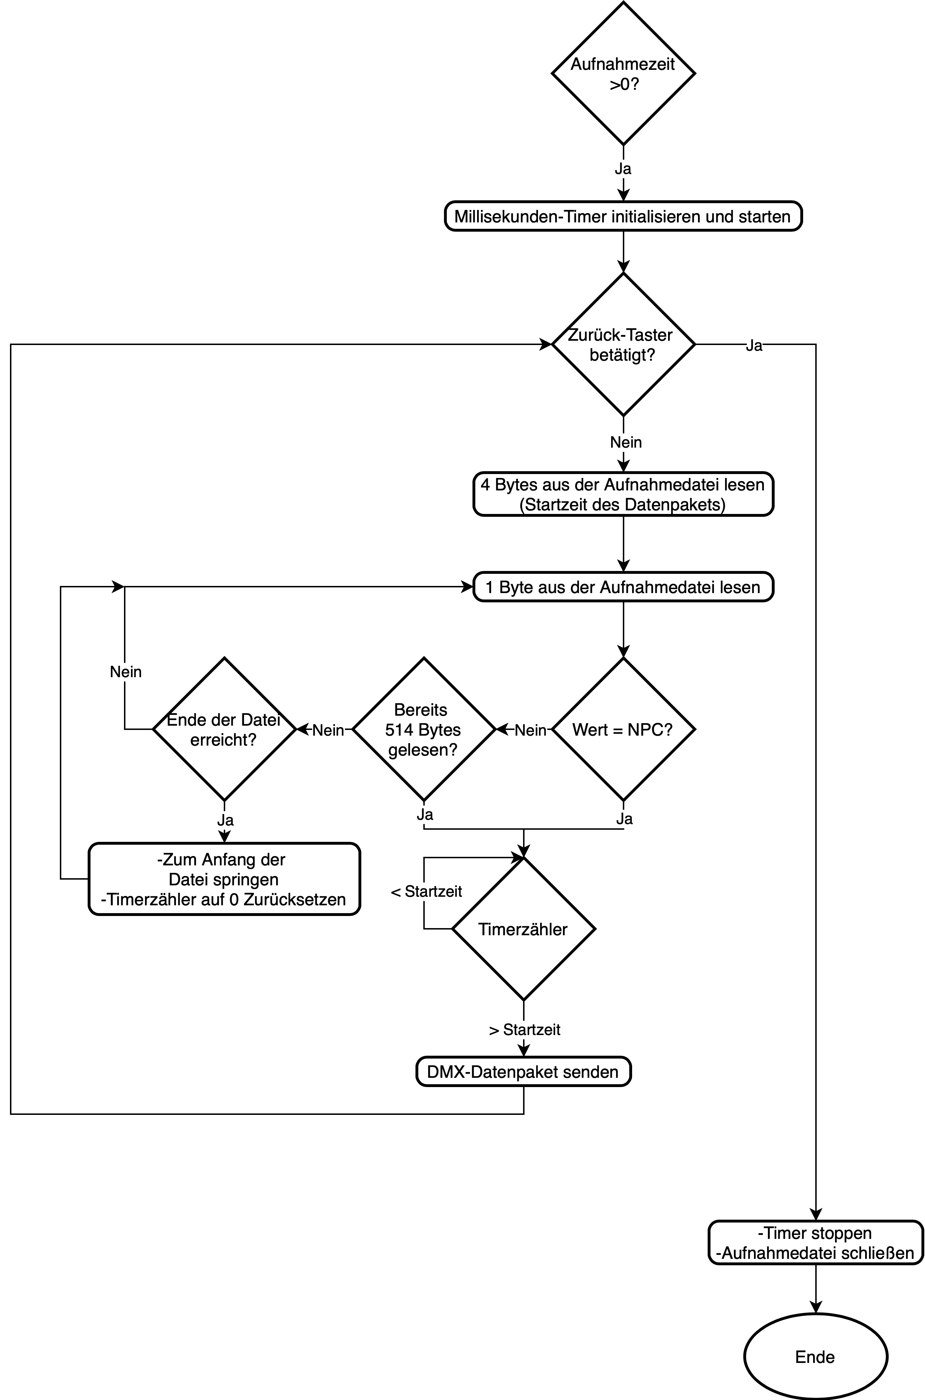
[picture p6: images/Wiedergabe_kontinuierlich.png]
		
	\end{center}
\end{figure}
\newpage
\section{Inhalt CD-ROM}
\label{CD-Anhang}
\begin{figure}[h]
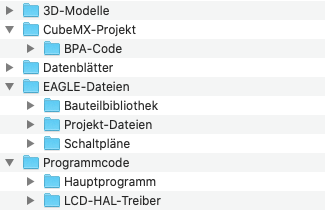
[picture p7: images/CD-Inhalt.png]
	
\end{figure}
