Felix7635/BA-Dokumentation/BA-Bauer.pdf

## Entwicklung eines Aufnahme- und

## Wiedergabeger¨ates fur DMX-Daten ¨

Bachelorabschlussarbeit

von

Felix Bauer

Im Studiengang B.Eng Elektrotechnik/Informationstechnik

mit Schwerpunkt Mess- und Automatisierungstechnik

an der HAWK Hochschule fur angewandte Wissenschaft und Kunst ¨

Hildesheim/Holzminden/G¨ottingen

Fakult¨at Ingenieurwissenschaften und Gesundheit in G¨ottingen

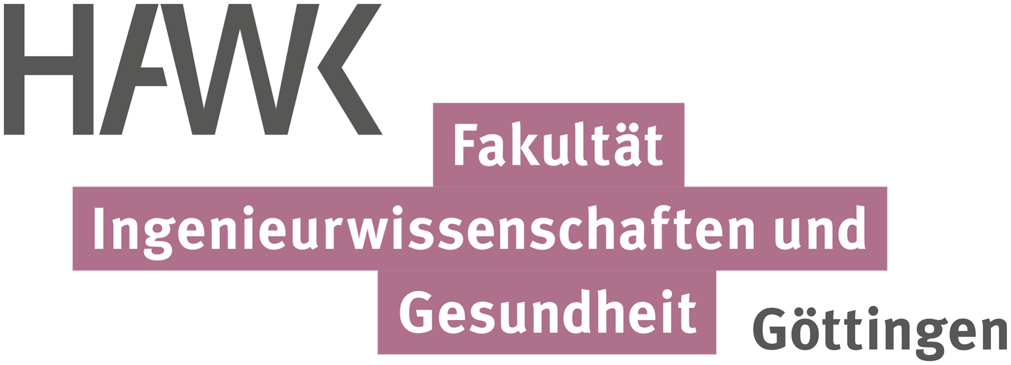
[picture p8: figure]

Erstprufer: Prof. Dr. rer. nat. Roman Grothausmann ¨

Zweitprufer: Dipl.-Ing. Tobias B ¨ | urmann ¨
21. Juni 2021

Selbstständigkeitserklärung

Hiermit erkläre ich, dass ich die vorliegende Abschlussarbeit selbstständig, ohne fremde Hilfe und nur unter Verwendung der angegebenen Literatur angefertigt habe. Alle fremden, öffentlichen Quellen sind als solche kenntlich gemacht. Mir ist bekannt, dass ich für die Quellen Dritter in dieser Arbeit die Nutzungsrechte zur Verwendung in dieser Arbeit benötige. Weiterhin versichere ich, dass diese Abschlussarbeit noch keiner anderen Prüfungskommission vorgelegen hat.

Göttingen, den | Unterschrift

Erklärung zu Nutzungsrechten und Verwertungsrechten

Ich bin hiermit einverstanden,
dass von meiner Abschlussarbeit (ggf. nach Ablauf der Sperre) 1 Vervielfältigungsstück erstellt werden kann, um es der Bibliothek der HAWK zur Verfügung zu stellen und Dritten öffentlich zugänglich zu machen.
Ich erkläre, dass Rechte Dritter der Veröffentlichung nicht entgegenstehen.
Göttingen, den | Unterschrift

Sperrvermerk der Abschlussarbeit

[ ] NEIN*
JA / Dauer der Sperre: | [ ] 3 Jahre* [ ] 5 Jahre*
Göttingen, den | | Unterschrift

* Zutreffendes bitte ankreuzen
- Dadurch räumen Sie der HAWK ein einfaches, zeitlich unbeschränktes, unentgeltliches Nutzungsrecht nach §§ 15 Abs. 2 Nr. 2, 16,17,19a, 31 Abs. 2 UrhG ein.

Inhaltsverzeichnis

1 Einleitung | 3
2 Entwicklungsschritte | 4
3 Hardware | 5
4 Software | 6

### 1 Einleitung

### 2 Entwicklungsschritte

### 3 Hardware

### 3.1 Schaltungsprinzip

### 3.2 ST-Microelectronics STM32F446ZE

### 3.3 Maxim Integrated RS485 Treiberchip

### 3.4 Encoder

### 3.5 LCD

### 4 Software

Literatur

Abbildungen
