Felix7635/BA-Dokumentation/Anhang/EAGLE-Dateien/Schaltpläne/Hauptschaltung.png

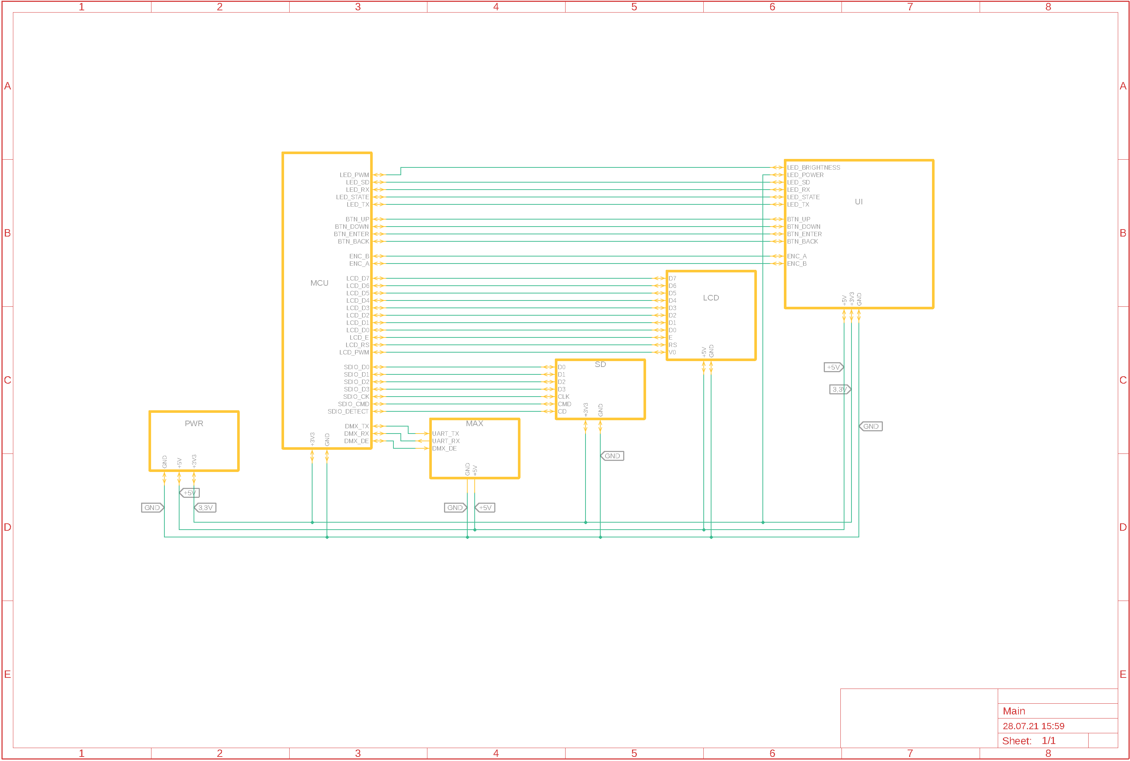
Anhang/EAGLE-Dateien/Schaltpläne/Hauptschaltung.png
