Felix7635/BA-Dokumentation/Anhang/EAGLE-Dateien/Schaltpläne/Modul - F446ZE.png

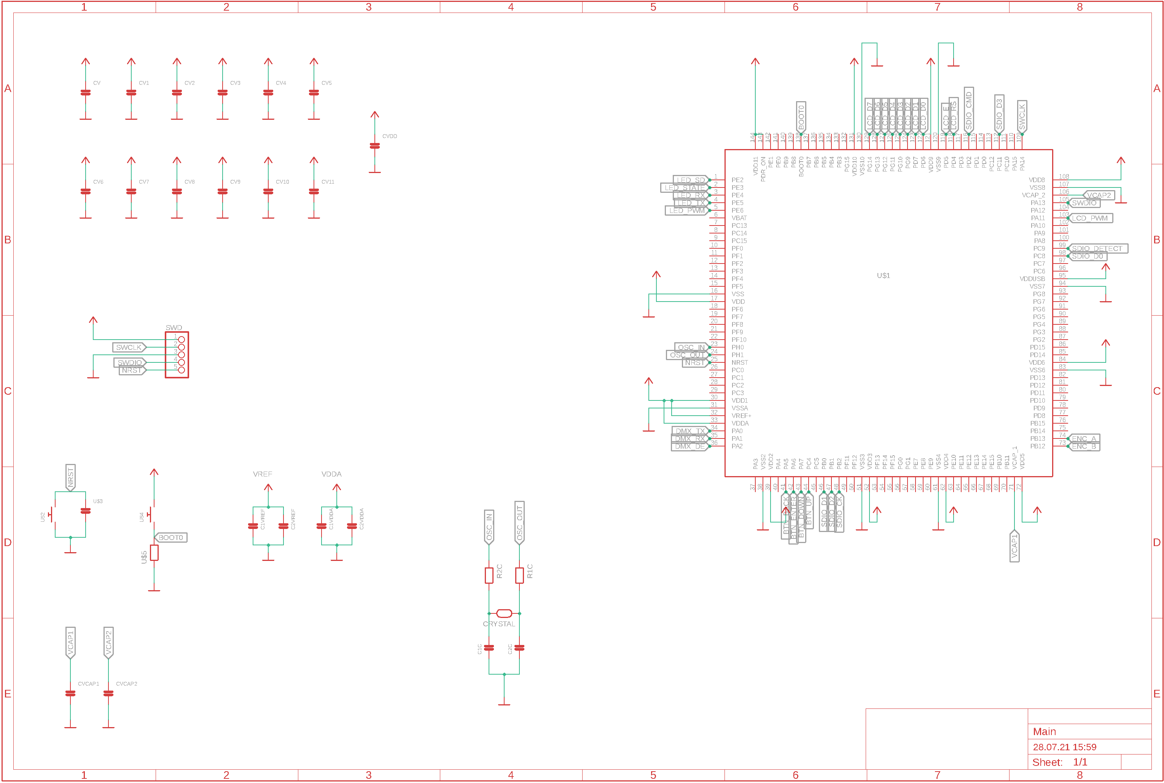
Anhang/EAGLE-Dateien/Schaltpläne/Modul - F446ZE.png
