Felix7635/BA-Dokumentation/Anhang/EAGLE-Dateien/Schaltpläne/Modul - GUI.png

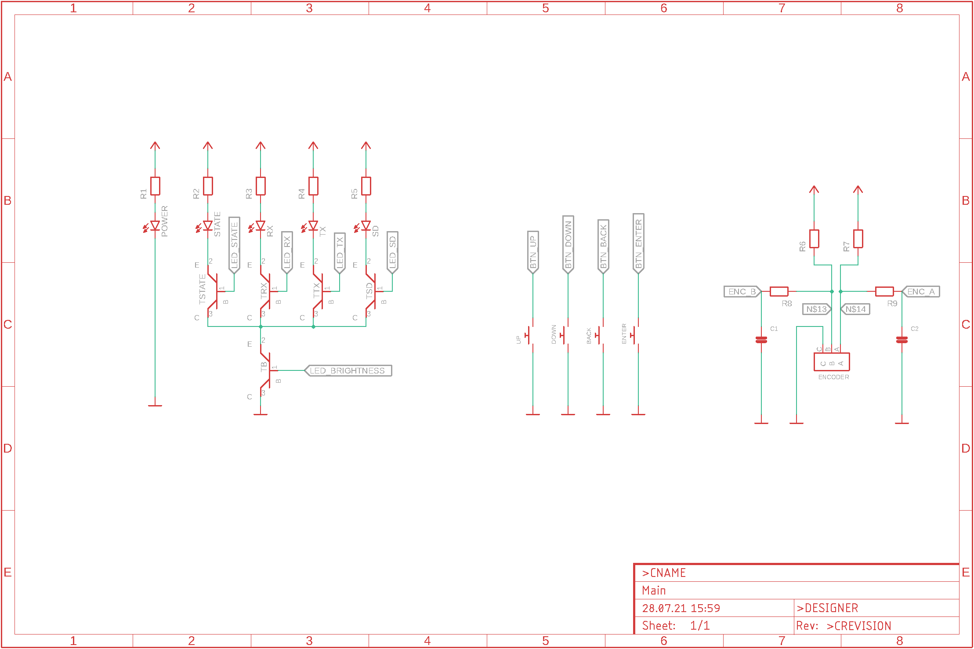
Anhang/EAGLE-Dateien/Schaltpläne/Modul - GUI.png
