Felix7635/BA-Dokumentation/Anhang/EAGLE-Dateien/Schaltpläne/Modul - LCD.png

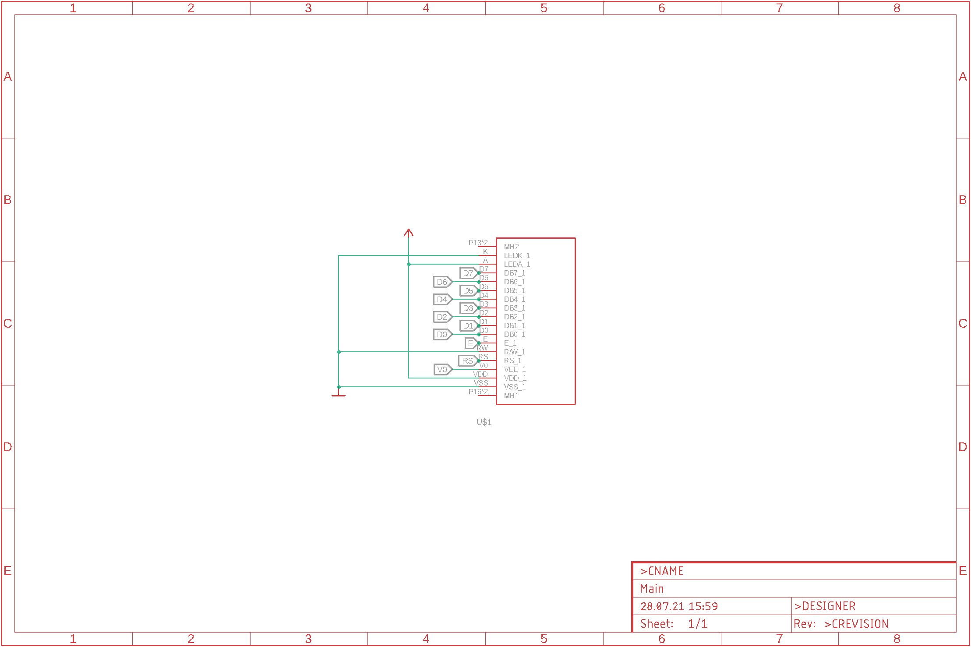
Anhang/EAGLE-Dateien/Schaltpläne/Modul - LCD.png
