Felix7635/BA-Dokumentation/Anhang/EAGLE-Dateien/Schaltpläne/Modul - Power.png

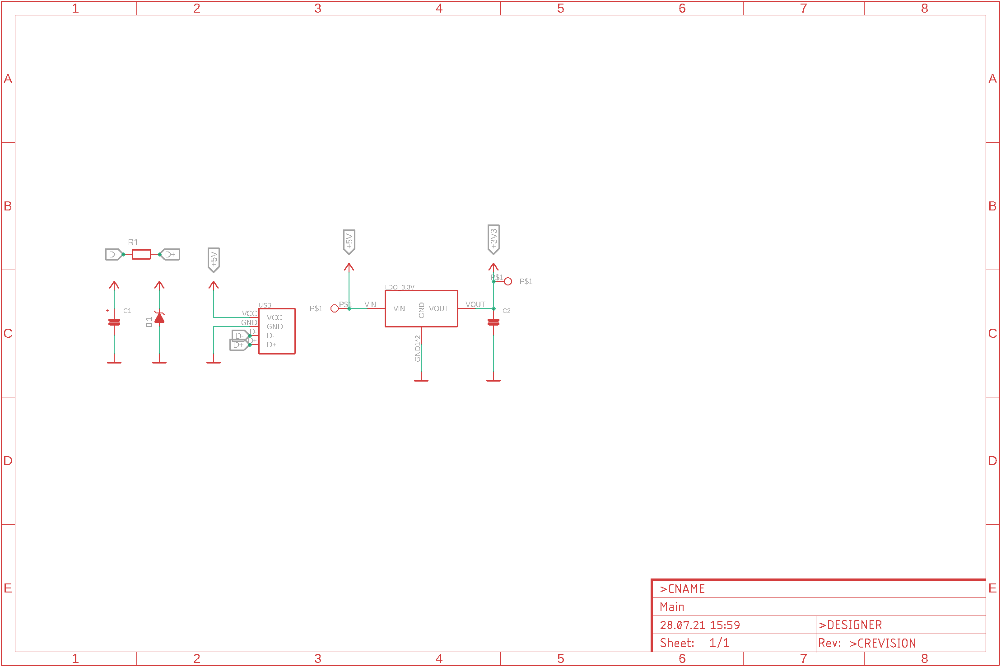
Anhang/EAGLE-Dateien/Schaltpläne/Modul - Power.png
