Felix7635/BA-Dokumentation/Anhang/EAGLE-Dateien/Schaltpläne/Modul - RS485.png

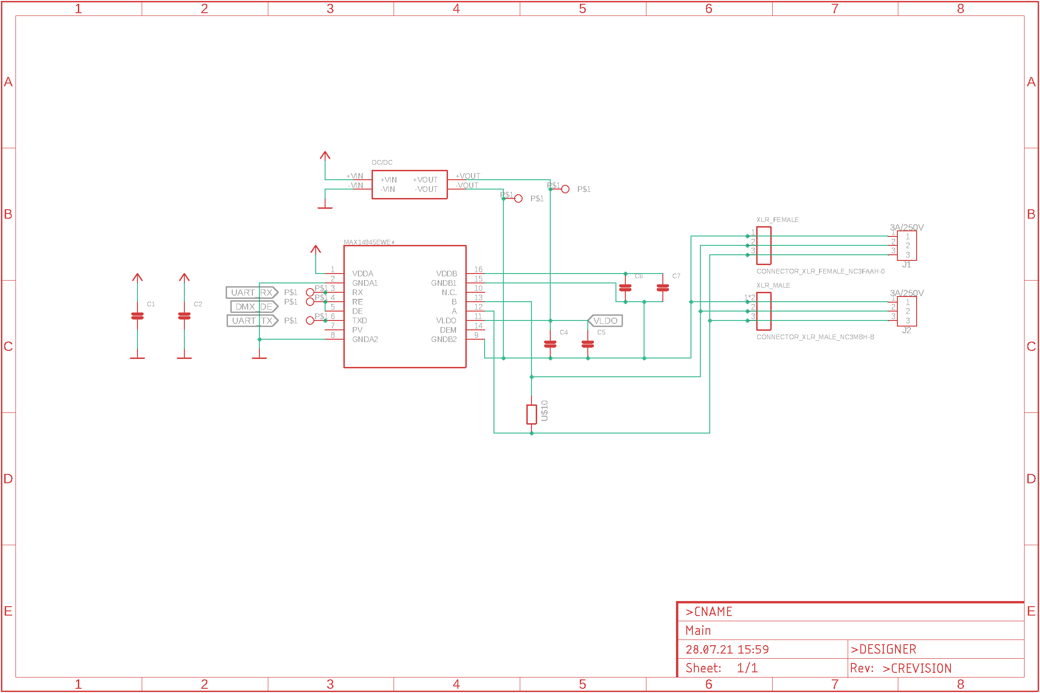
Anhang/EAGLE-Dateien/Schaltpläne/Modul - RS485.png
