Felix7635/BA-Dokumentation/Anhang/EAGLE-Dateien/Schaltpläne/Modul - SD.png

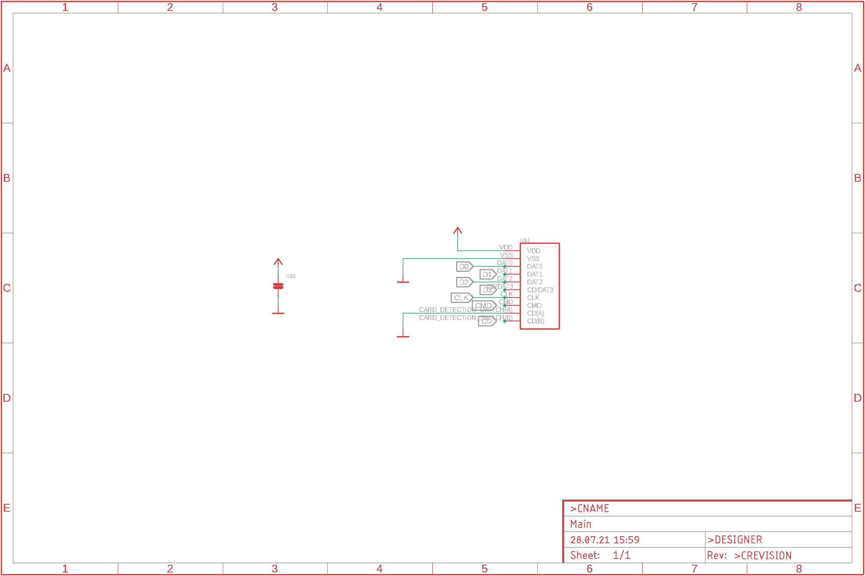
Anhang/EAGLE-Dateien/Schaltpläne/Modul - SD.png
