Felix7635/BA-Dokumentation/images/CubeMX-clock-mark.png

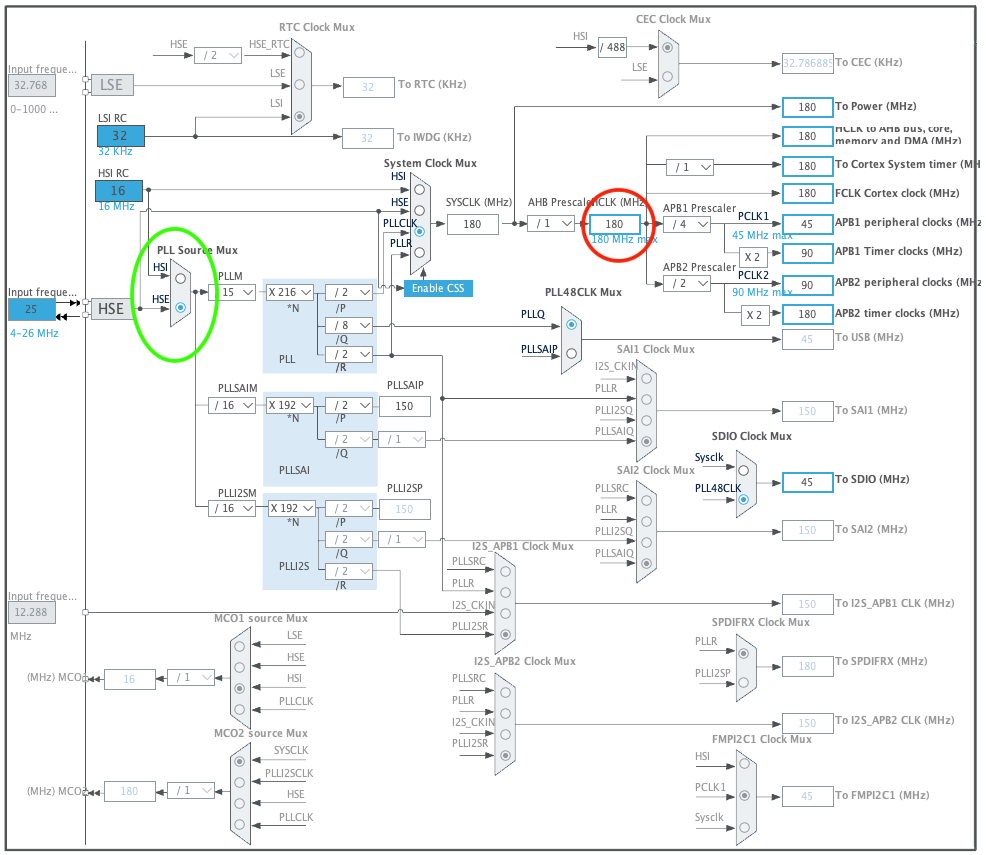
images/CubeMX-clock-mark.png
