Felix7635/BA-Dokumentation/images/CubeMX-timerconfig.png

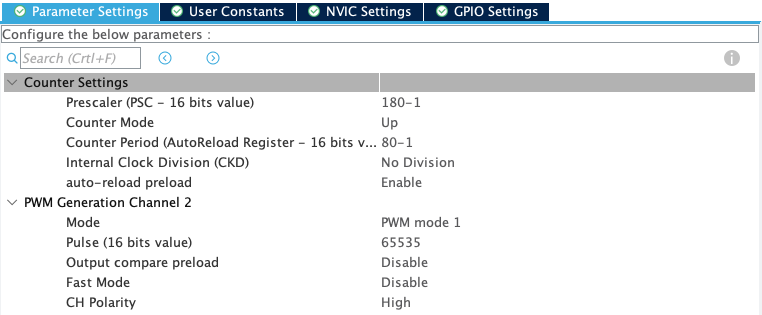
images/CubeMX-timerconfig.png
