Felix7635/BA-Dokumentation/images/Encoder-Schaltung-Eagle.png

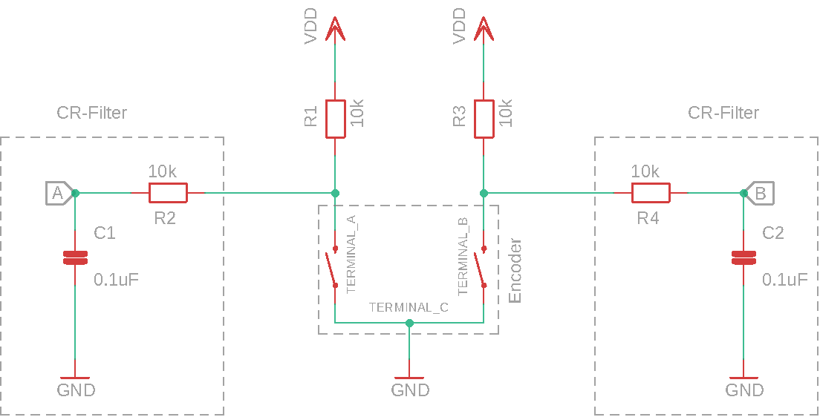
images/Encoder-Schaltung-Eagle.png
