Felix7635/BA-Dokumentation/images/Encoder-Schaltung.png

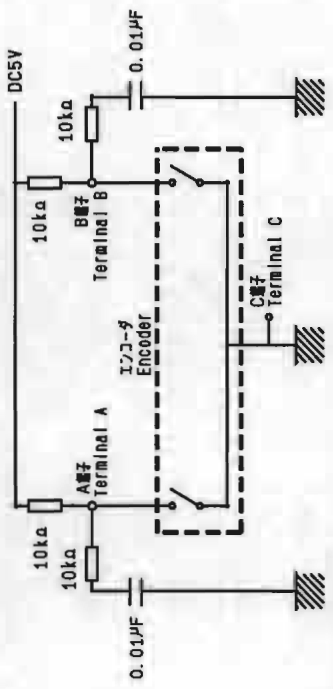
images/Encoder-Schaltung.png
