Felix7635/BA-Dokumentation/images/Encoder-signal.png

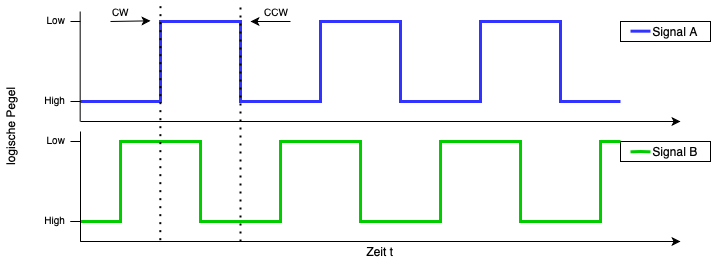
images/Encoder-signal.png
