Felix7635/BA-Dokumentation/images/Housing-back.png

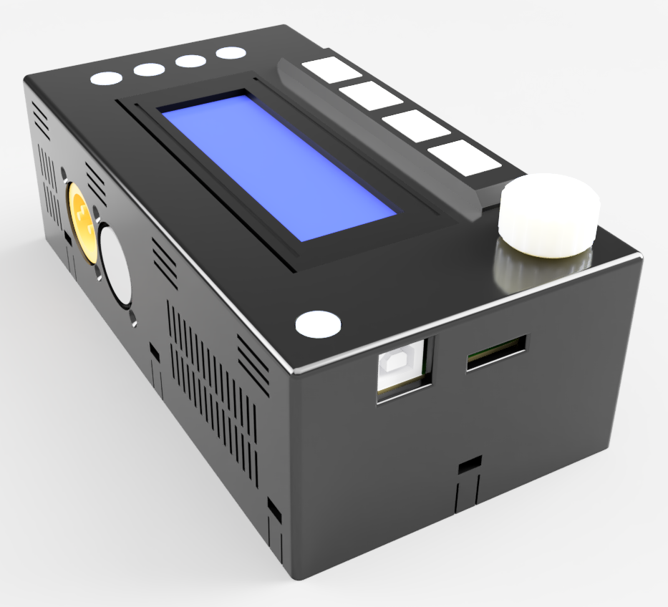
images/Housing-back.png
