Felix7635/BA-Dokumentation/images/Housing-front.png

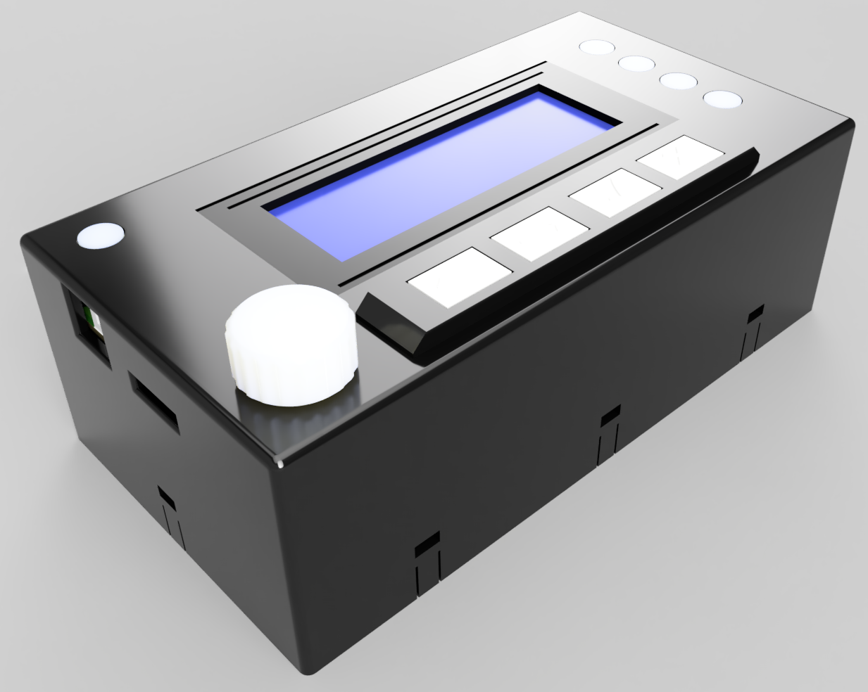
images/Housing-front.png
