Felix7635/BA-Dokumentation/images/Housing-Schnitt-Befestigung2-mark.png

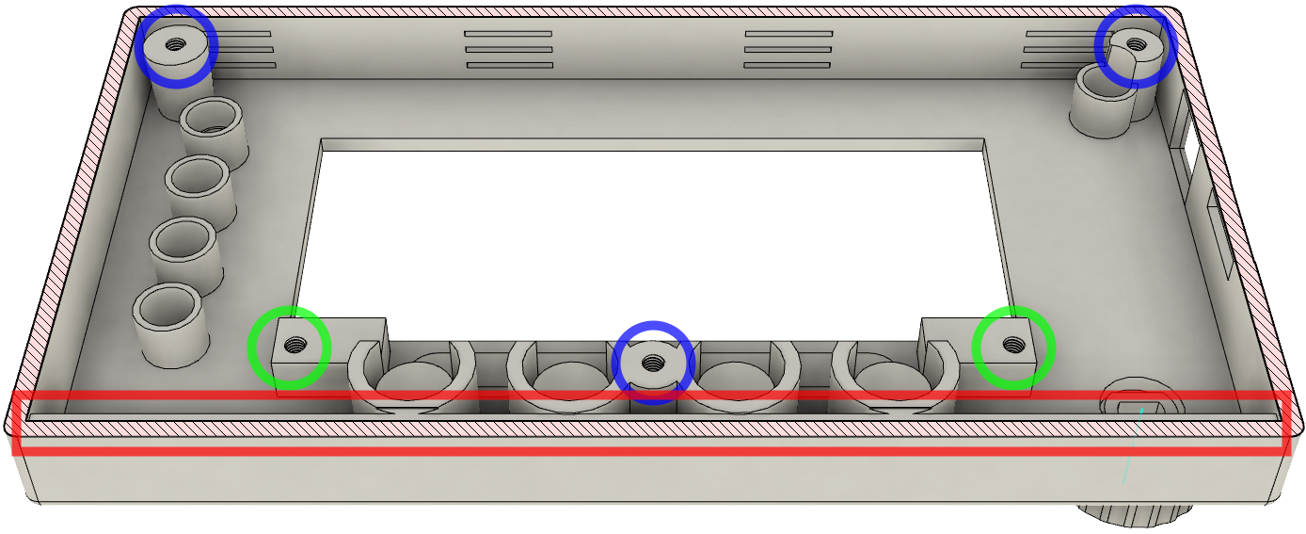
images/Housing-Schnitt-Befestigung2-mark.png
