Felix7635/BA-Dokumentation/images/Housing-Schnitt-Befestigung2.png

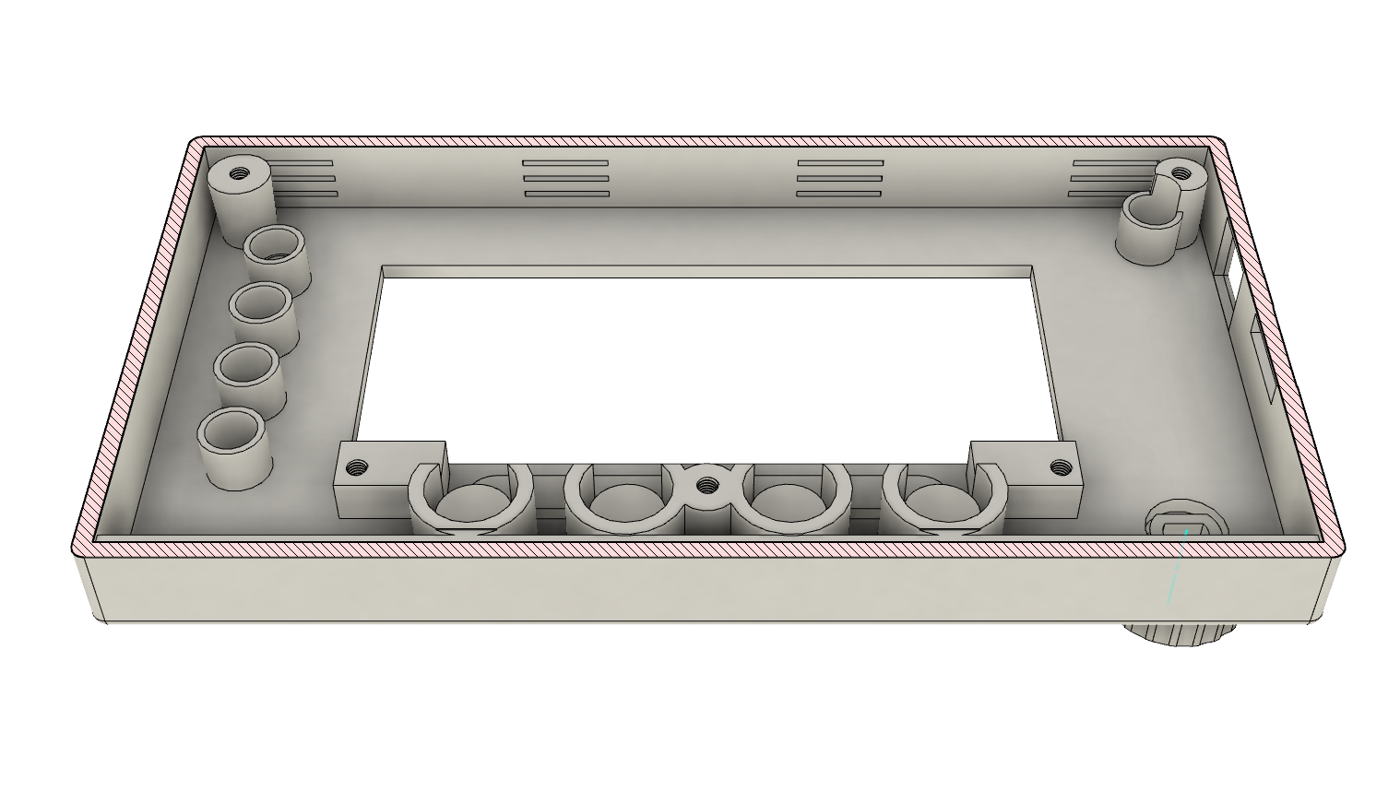
images/Housing-Schnitt-Befestigung2.png
