Felix7635/BA-Dokumentation/images/Housing-Schnitt-Befestigung-mark.png

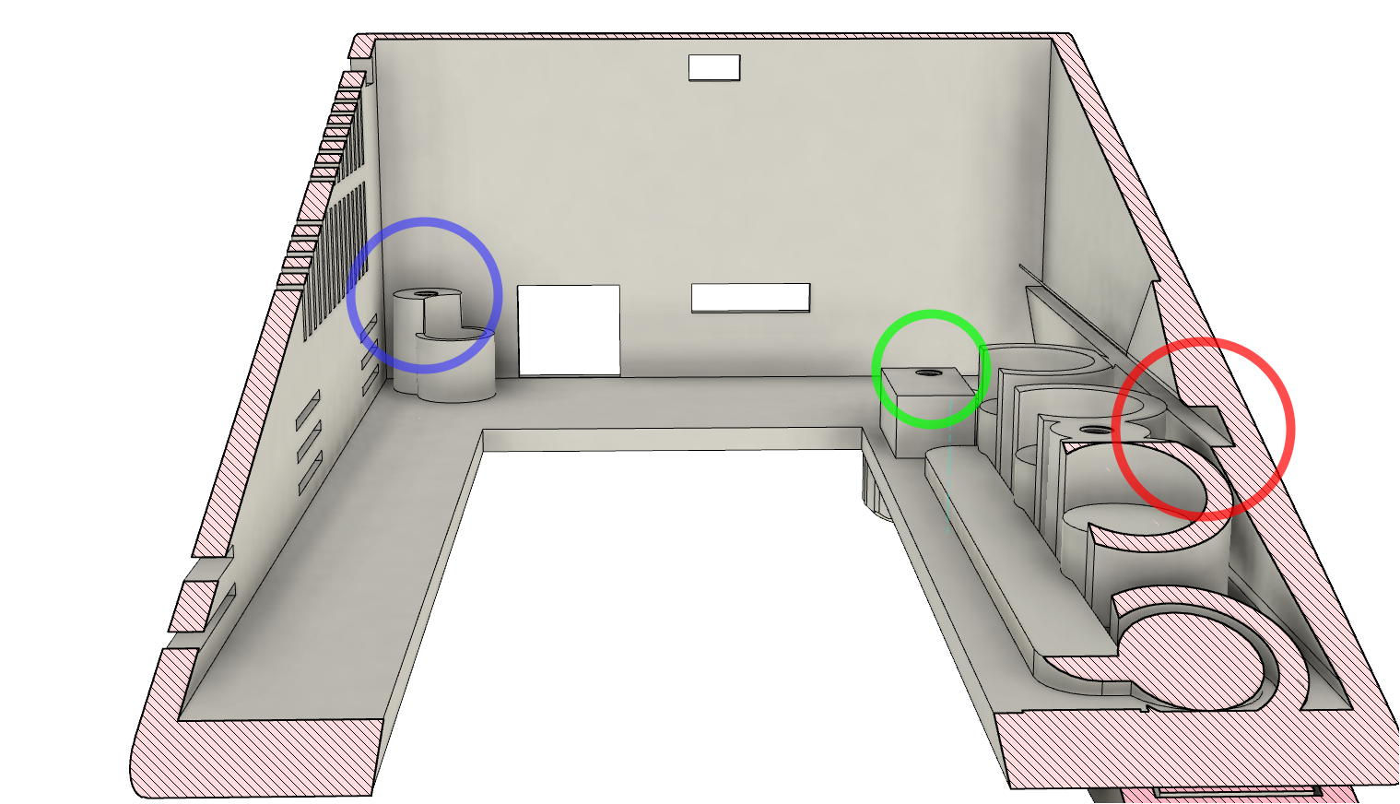
images/Housing-Schnitt-Befestigung-mark.png
