Felix7635/BA-Dokumentation/images/Housing-Schnitt-Button-crop.png

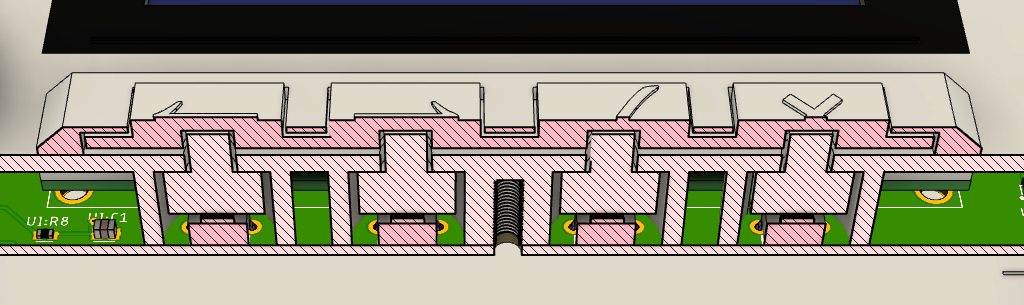
images/Housing-Schnitt-Button-crop.png
