Felix7635/BA-Dokumentation/images/Housing-Schnitt-Button-front-crop-mark.png

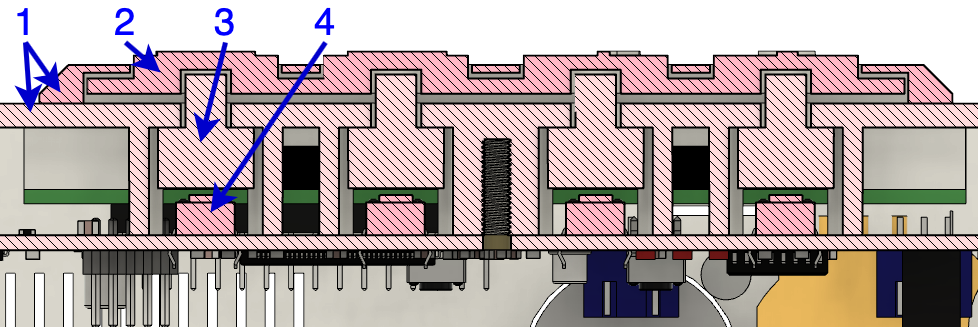
images/Housing-Schnitt-Button-front-crop-mark.png
