Felix7635/BA-Dokumentation/images/Housing-Schnitt-Button-front-crop.png

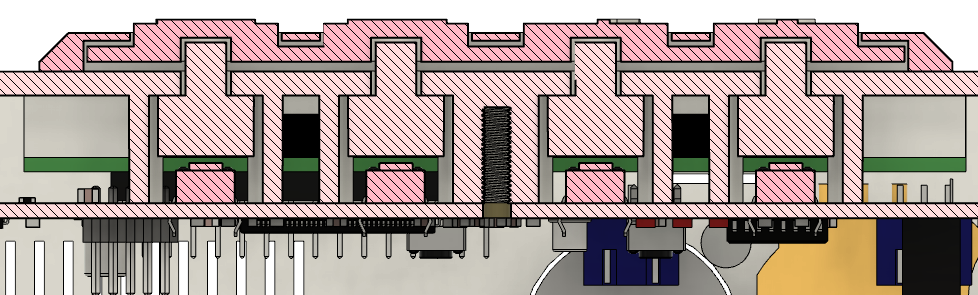
images/Housing-Schnitt-Button-front-crop.png
