Felix7635/BA-Dokumentation/images/Housing-Schnitt-Button-front.png

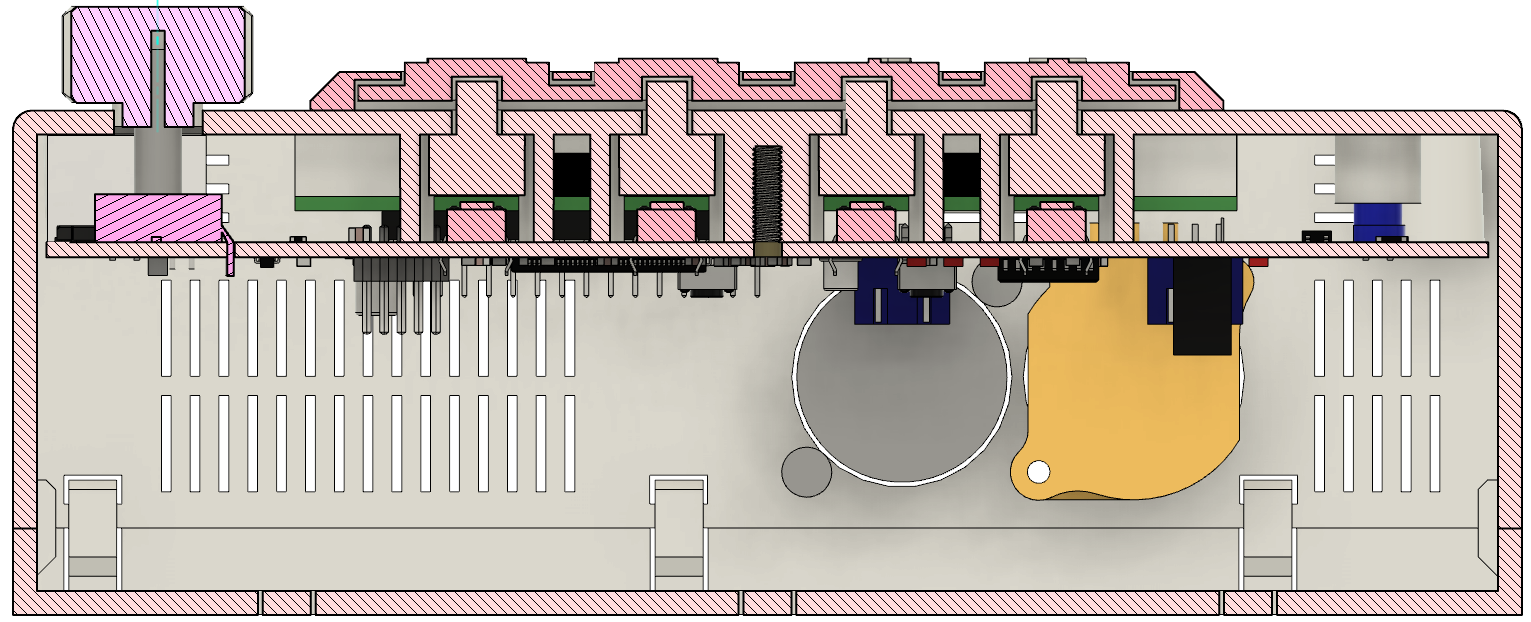
images/Housing-Schnitt-Button-front.png
