Felix7635/BA-Dokumentation/images/Housing-Schnitt-Button.png

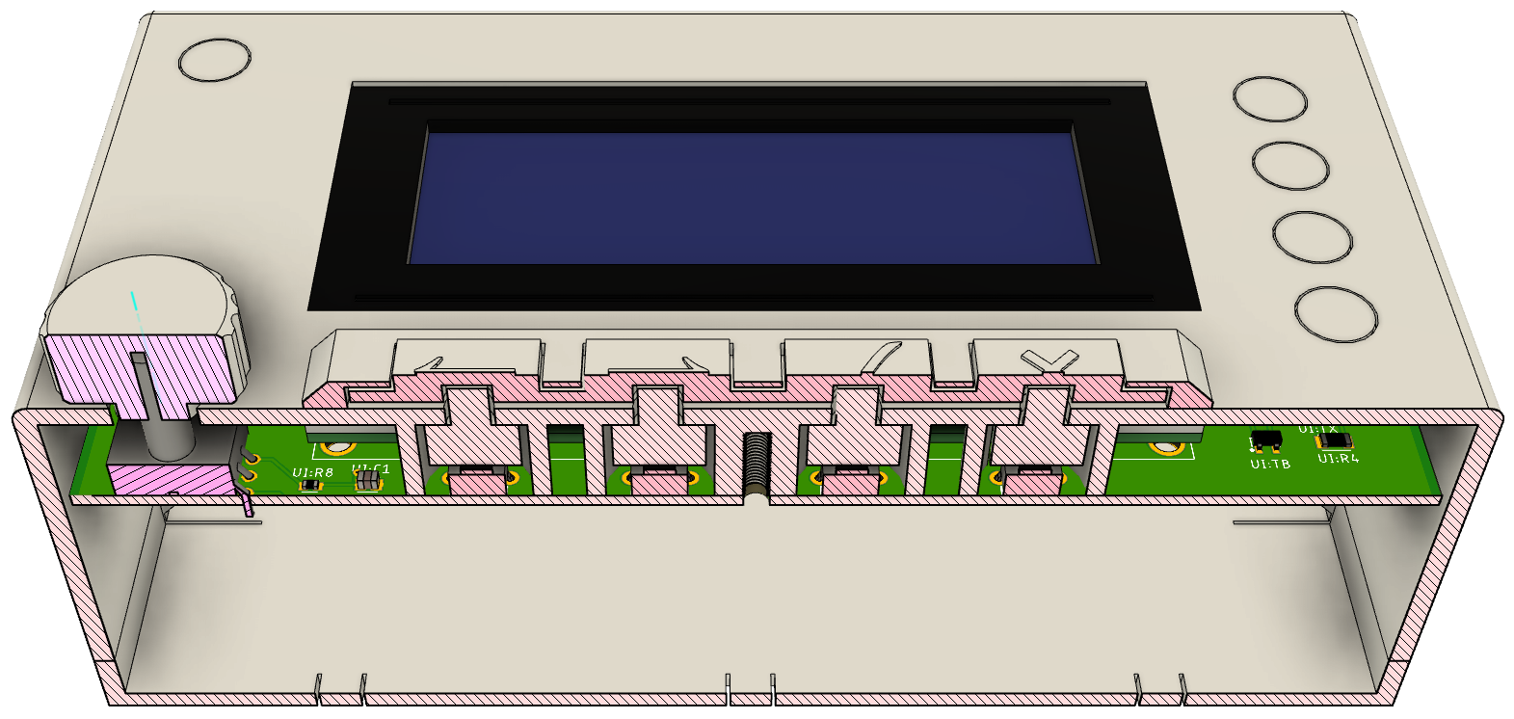
images/Housing-Schnitt-Button.png
