Felix7635/BA-Dokumentation/images/Housing-Schnitt-Clip-Seite.png

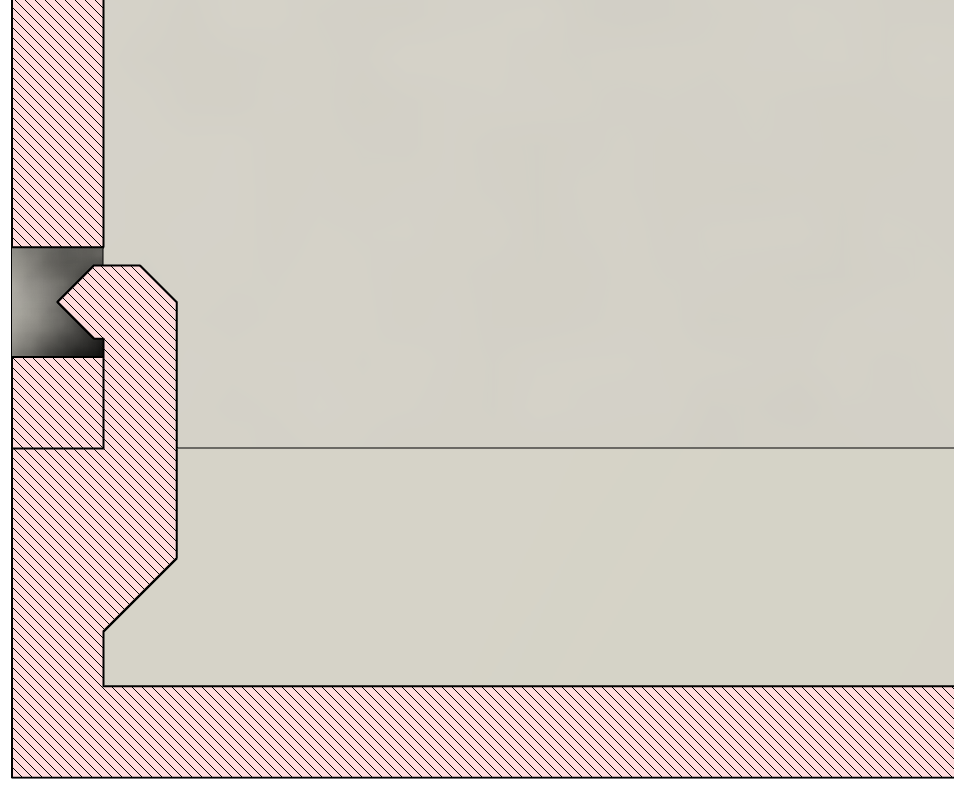
images/Housing-Schnitt-Clip-Seite.png
