Felix7635/BA-Dokumentation/images/Housing-Schnitt-Clip.png

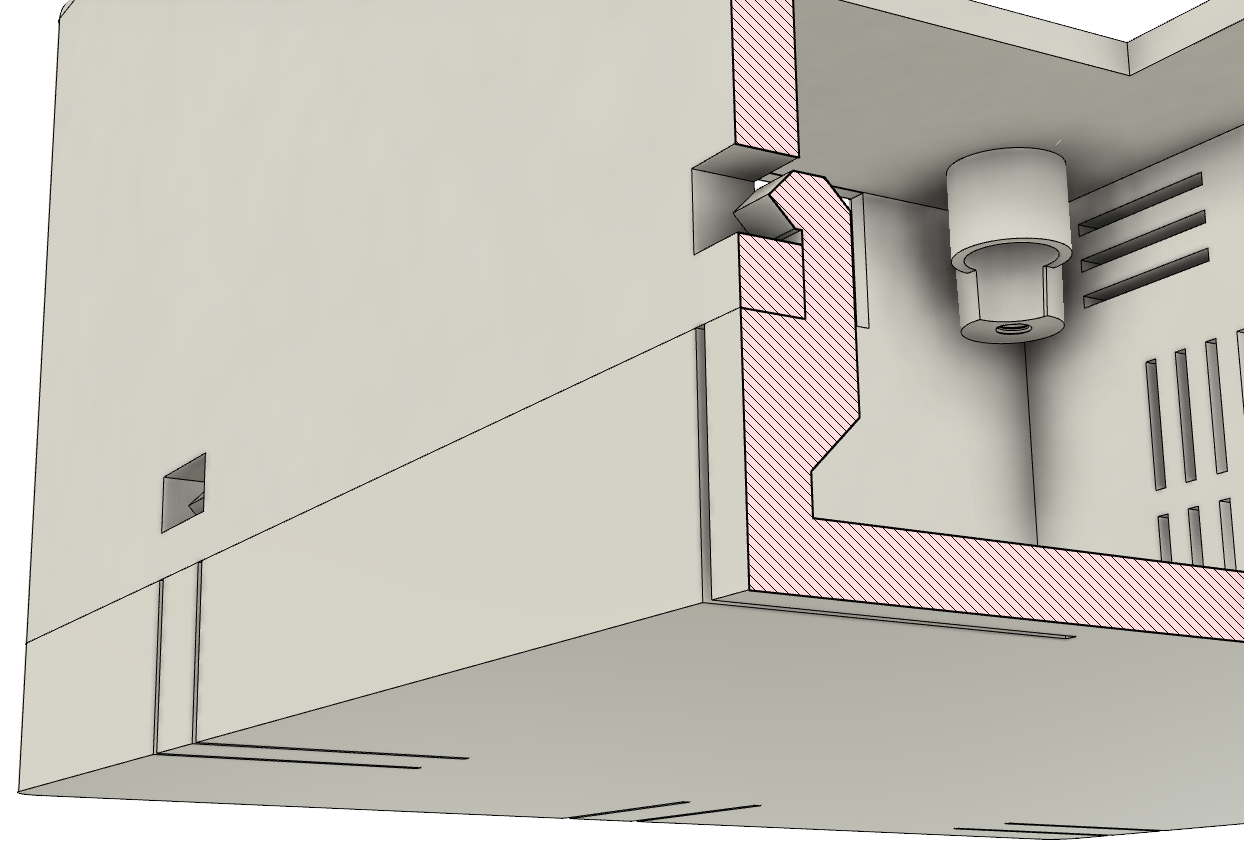
images/Housing-Schnitt-Clip.png
