Felix7635/BA-Dokumentation/images/Housing.png

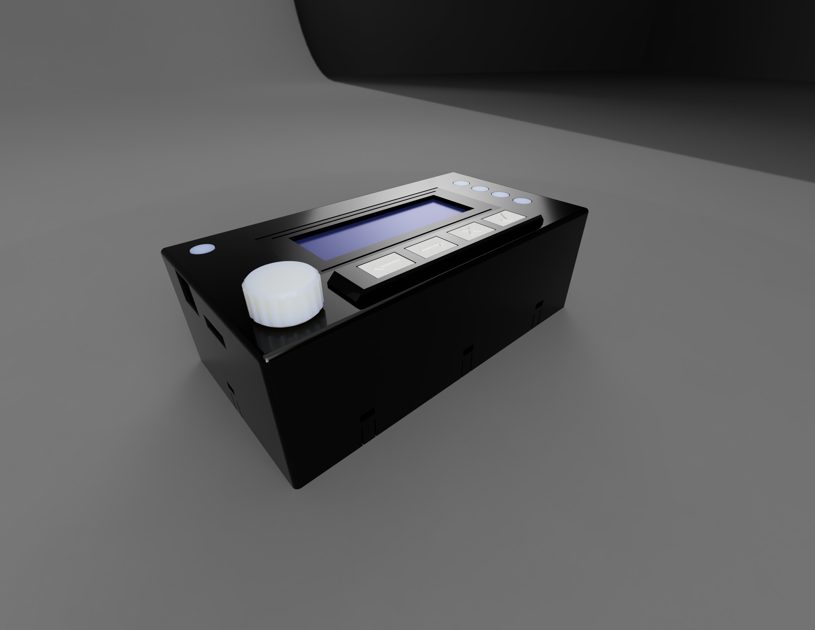
images/Housing.png
