Felix7635/BA-Dokumentation/images/LCD-Screenshots/Aufnahme.png

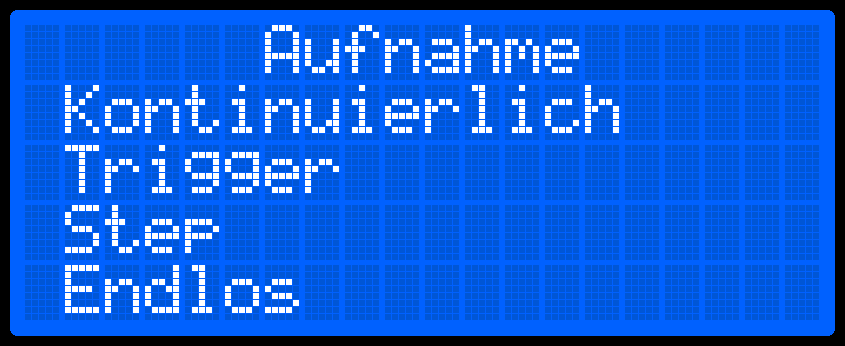
images/LCD-Screenshots/Aufnahme.png
