Felix7635/BA-Dokumentation/images/LCD-Screenshots/Einstellungen.png

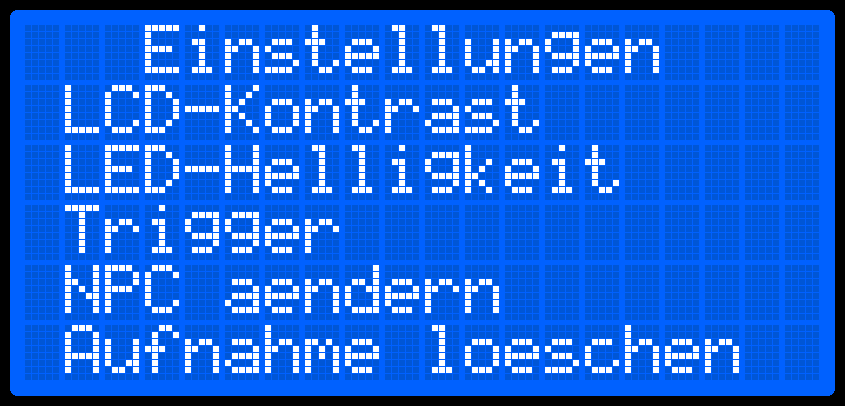
images/LCD-Screenshots/Einstellungen.png
