Felix7635/BA-Dokumentation/images/LCD-Screenshots/Hauptmenue.png

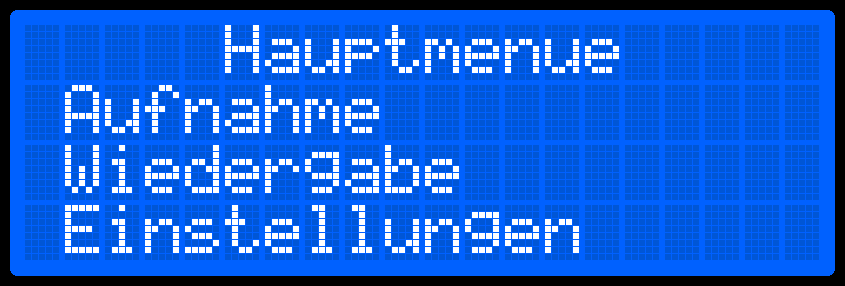
images/LCD-Screenshots/Hauptmenue.png
