Felix7635/BA-Dokumentation/images/LCD-Screenshots/LCDKontrast25.png

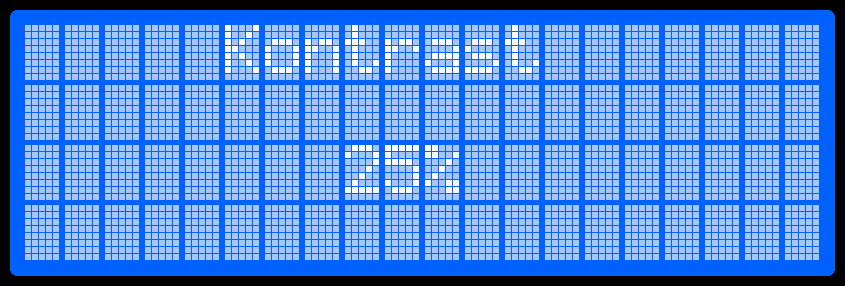
images/LCD-Screenshots/LCDKontrast25.png
