Felix7635/BA-Dokumentation/images/LCD-Screenshots/LCDKontrast50.png

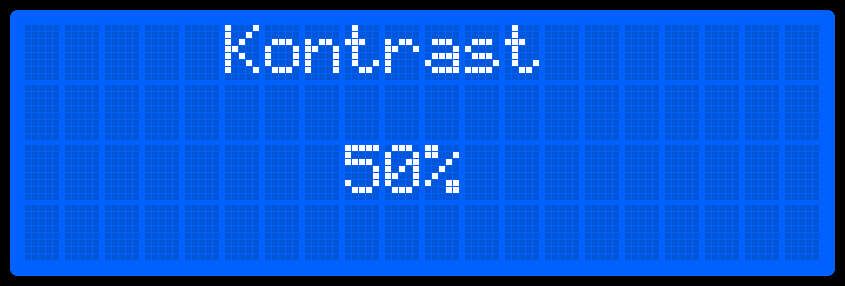
images/LCD-Screenshots/LCDKontrast50.png
