Felix7635/BA-Dokumentation/images/LCD-Screenshots/Namenauswahl.png

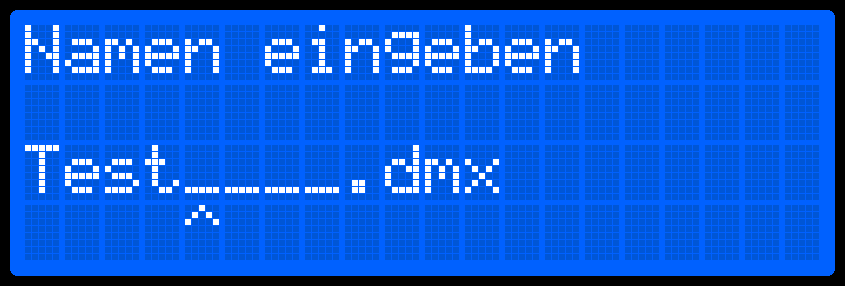
images/LCD-Screenshots/Namenauswahl.png
