Felix7635/BA-Dokumentation/images/LCD-Screenshots/NPC.png

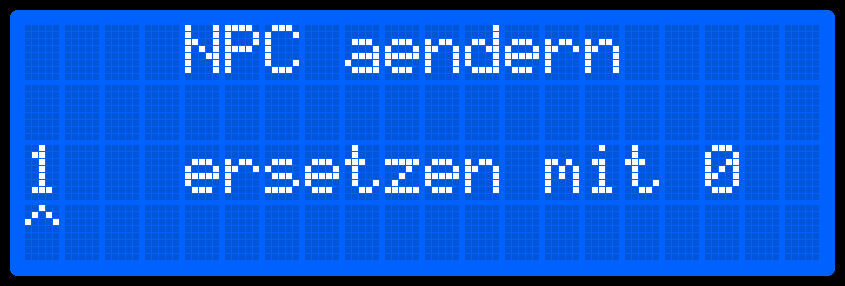
images/LCD-Screenshots/NPC.png
