Felix7635/BA-Dokumentation/images/LCD-Screenshots/Trigger.png

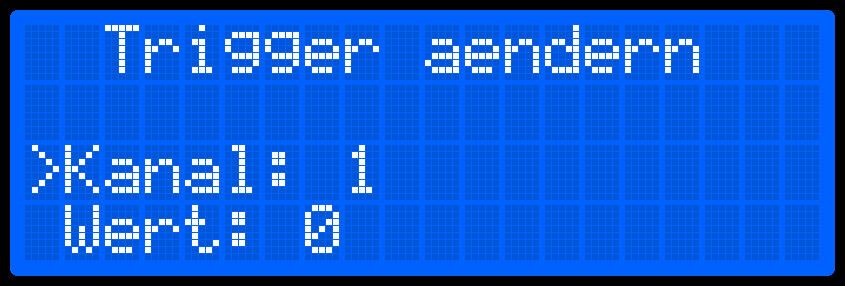
images/LCD-Screenshots/Trigger.png
