Felix7635/BA-Dokumentation/images/LCD-Screenshots/Wiedergabe.png

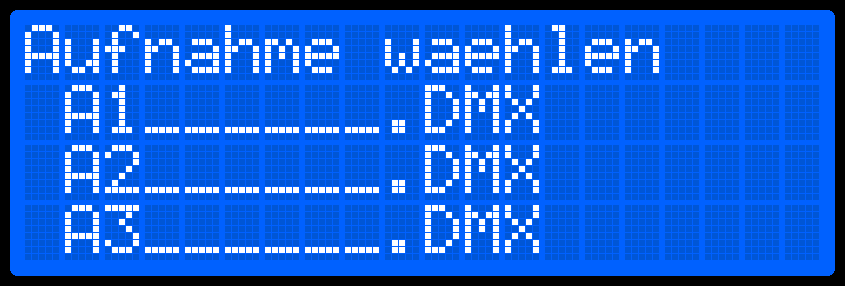
images/LCD-Screenshots/Wiedergabe.png
