Felix7635/BA-Dokumentation/images/LCD-Screenshots/Zeitauswahl.png

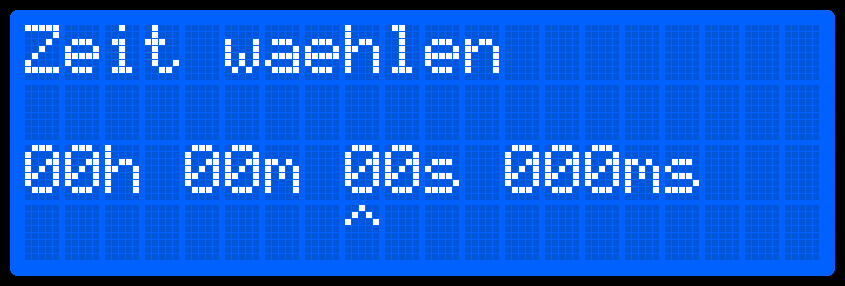
images/LCD-Screenshots/Zeitauswahl.png
