Felix7635/BA-Dokumentation/images/LED-Messung.png

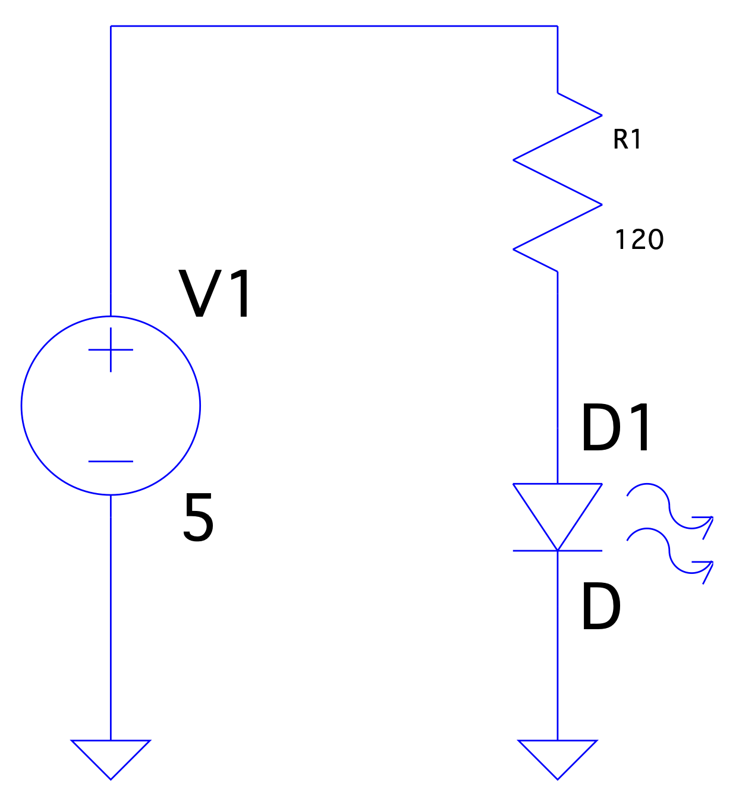
images/LED-Messung.png
