Felix7635/BA-Dokumentation/images/led-Schaltung.png

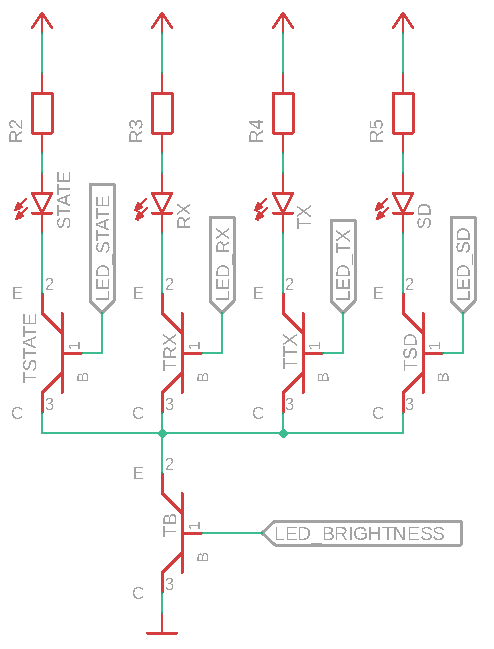
images/led-Schaltung.png
