Felix7635/BA-Dokumentation/images/lib-3d.png

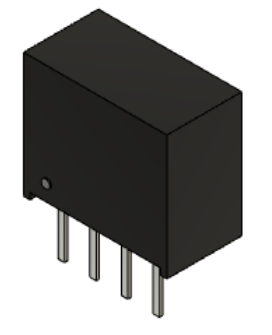
images/lib-3d.png
