Felix7635/BA-Dokumentation/images/lib-footprint.png

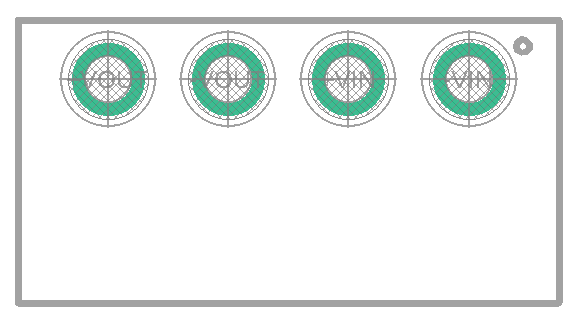
images/lib-footprint.png
