Felix7635/BA-Dokumentation/images/Lib-symbol.png

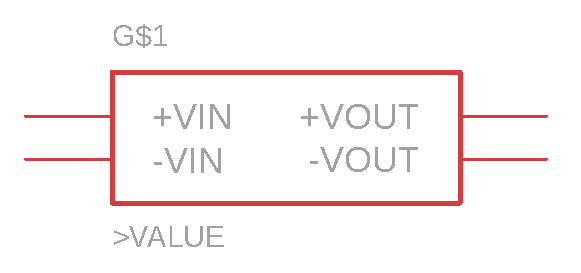
images/Lib-symbol.png
