Felix7635/BA-Dokumentation/images/MAX14945EWE-FunctionalDiagram.png

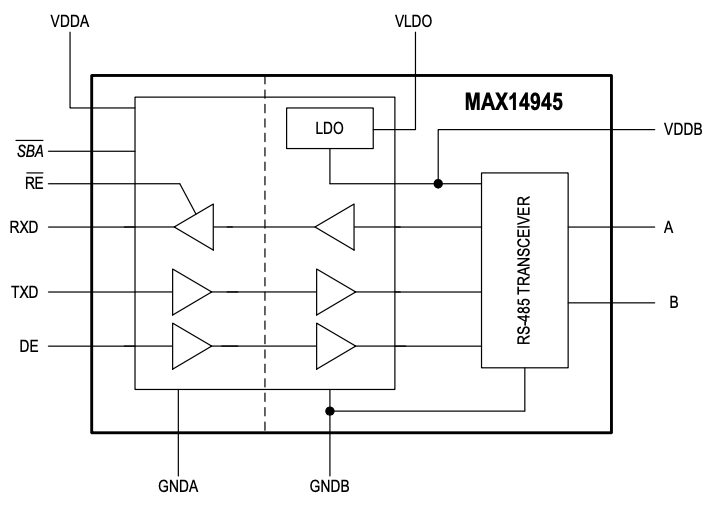
images/MAX14945EWE-FunctionalDiagram.png
