Felix7635/BA-Dokumentation/images/MAX14945EWE-FunctionalDiagram_mark.png

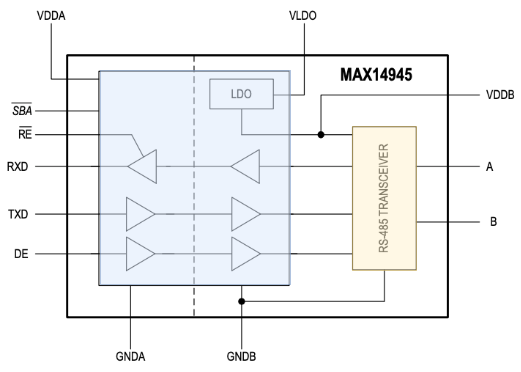
images/MAX14945EWE-FunctionalDiagram_mark.png
