Felix7635/BA-Dokumentation/images/MAX_typical.png

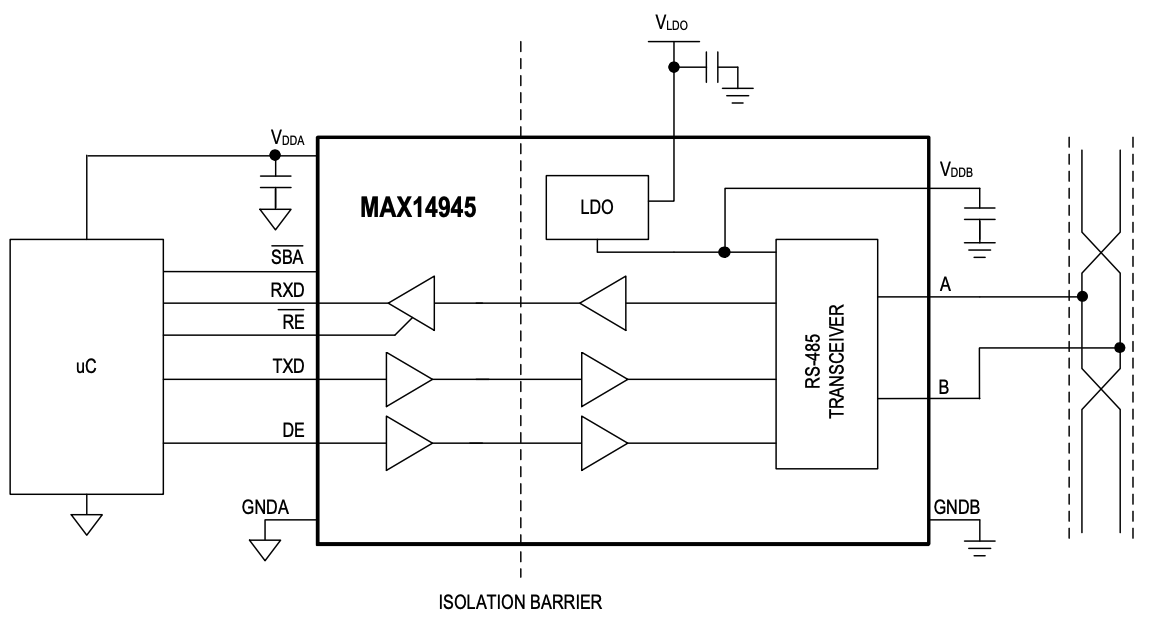
images/MAX_typical.png
