Felix7635/BA-Dokumentation/images/Menue.png

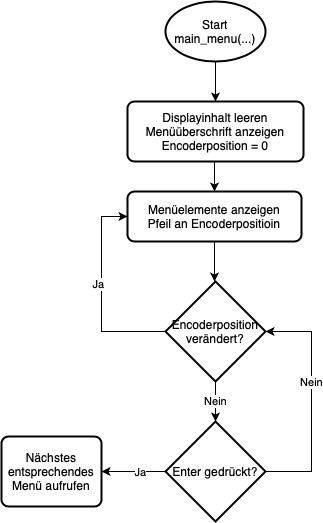
images/Menue.png
