Felix7635/BA-Dokumentation/images/Module-schematic.png

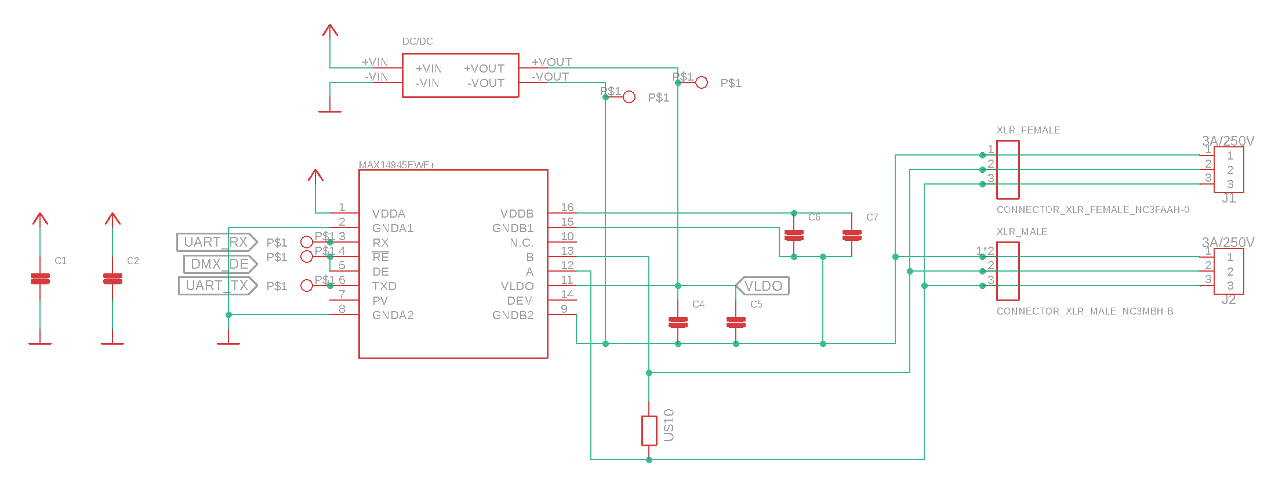
images/Module-schematic.png
