Felix7635/BA-Dokumentation/images/Module.png

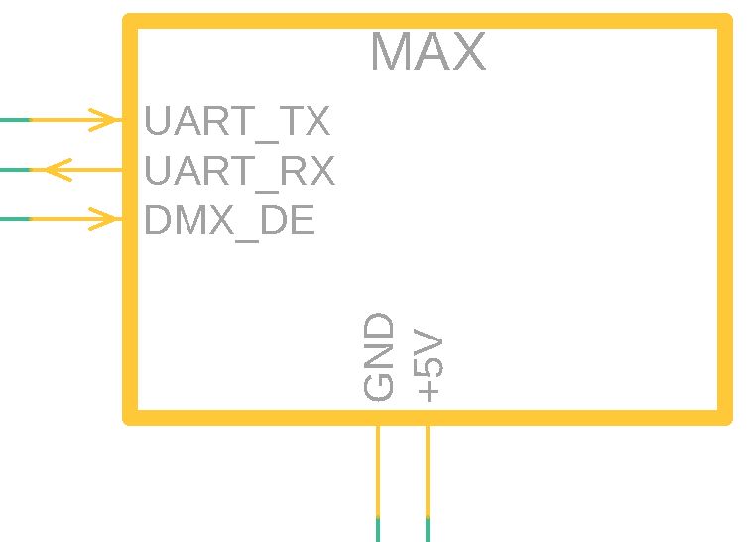
images/Module.png
