Felix7635/BA-Dokumentation/images/PCB-Design.png

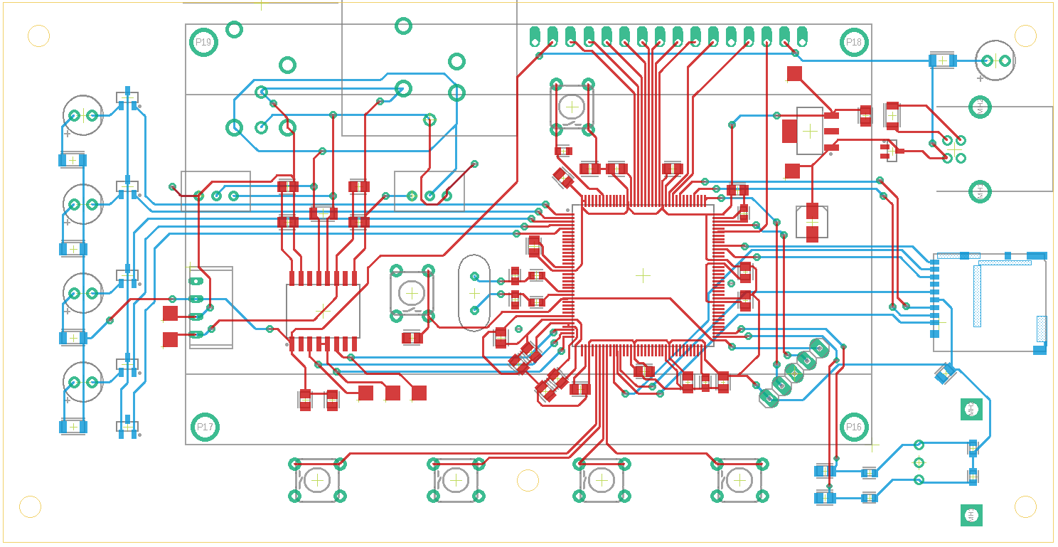
images/PCB-Design.png
