Felix7635/BA-Dokumentation/images/PCB-Design_mark.png

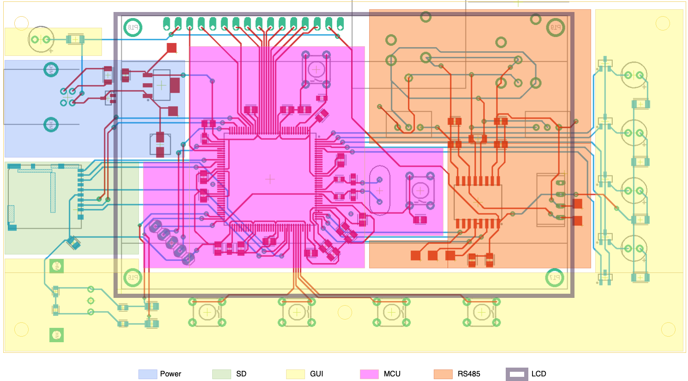
images/PCB-Design_mark.png
