Felix7635/BA-Dokumentation/images/PCB_bottom.png

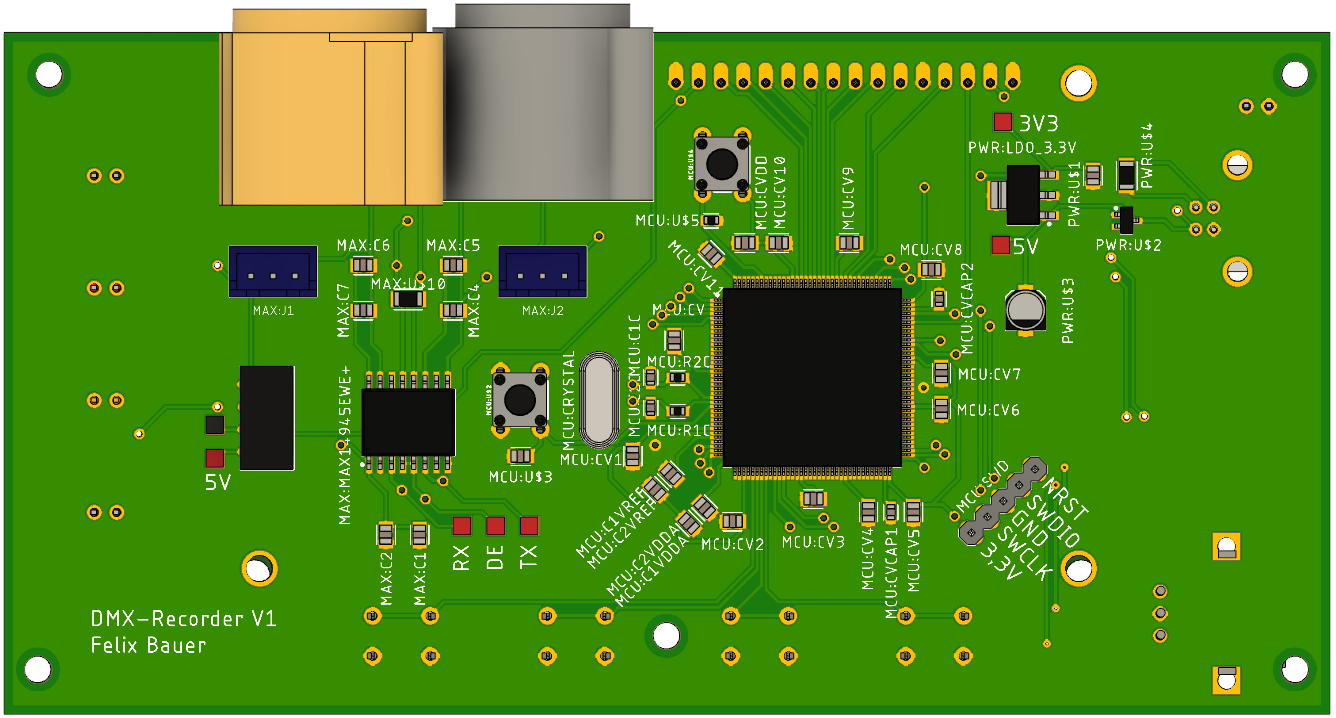
images/PCB_bottom.png
