Felix7635/BA-Dokumentation/images/PCB_top.png

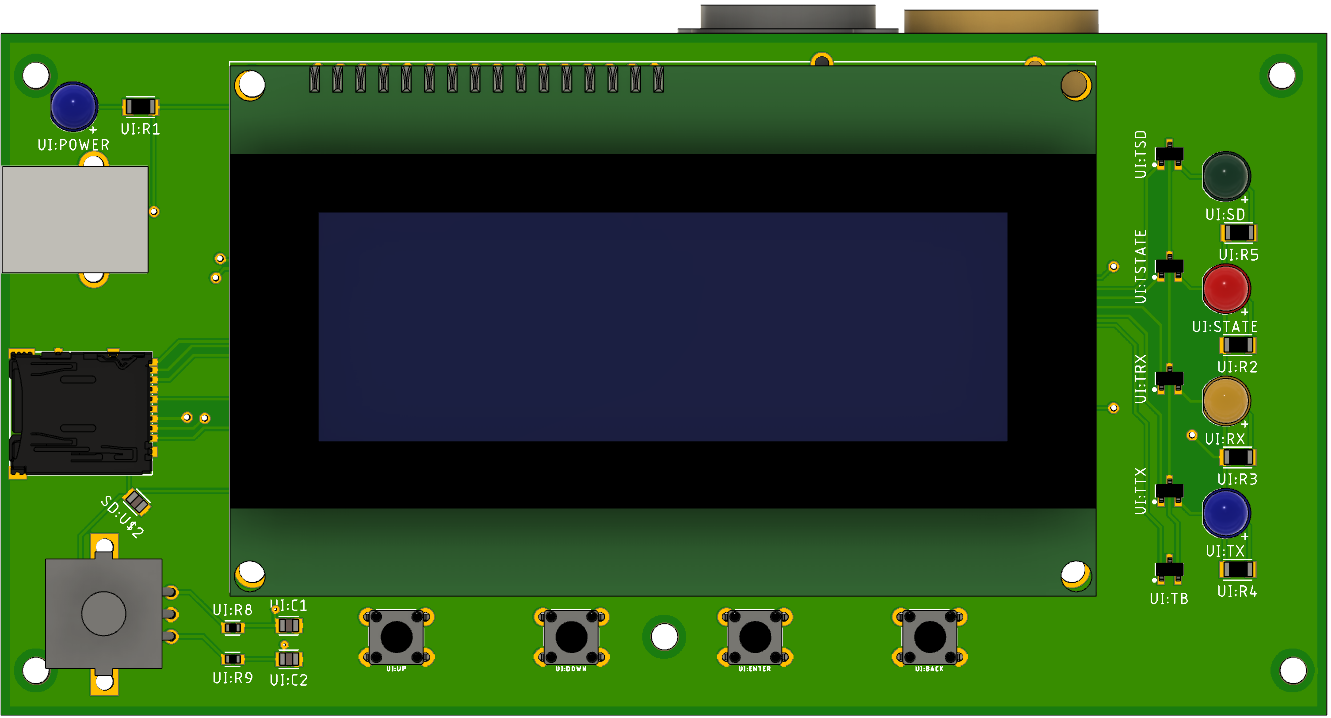
images/PCB_top.png
