Felix7635/BA-Dokumentation/images/PCB_top_noLCD.png

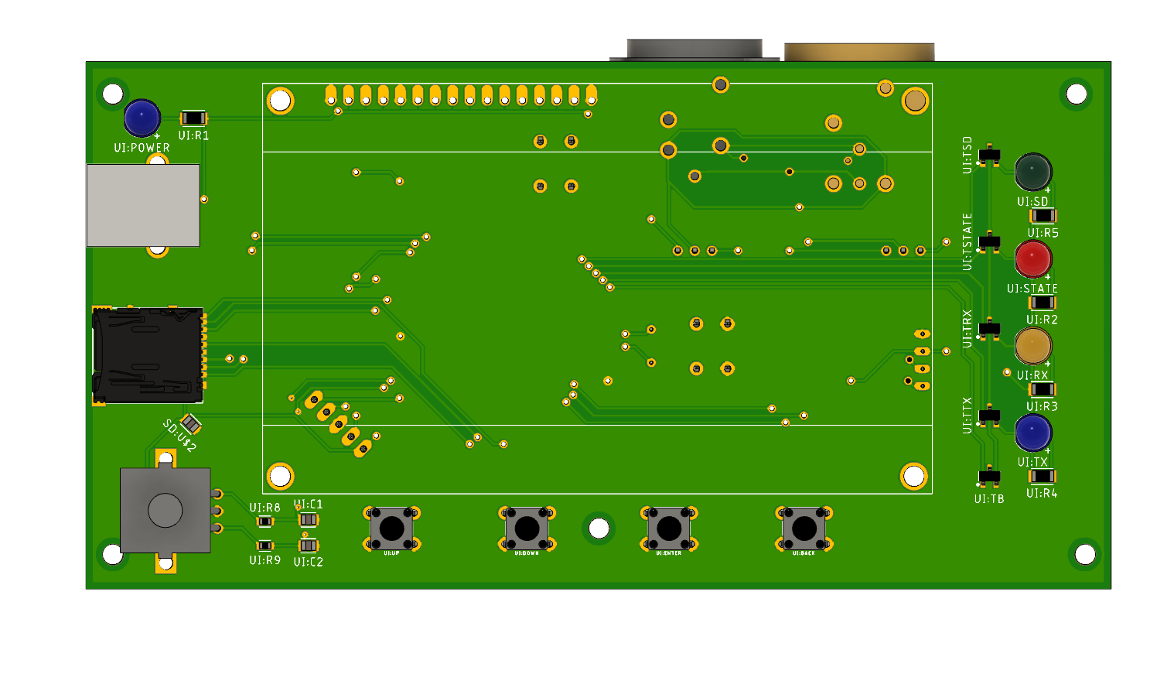
images/PCB_top_noLCD.png
