Felix7635/BA-Dokumentation/images/PWM25.png

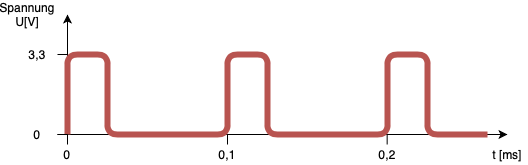
images/PWM25.png
