Felix7635/BA-Dokumentation/images/PWM75.png

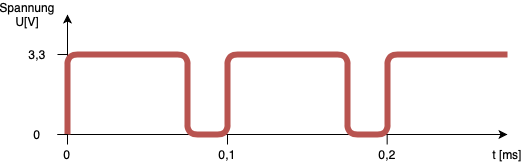
images/PWM75.png
