Felix7635/BA-Dokumentation/images/Schaltung-power.png

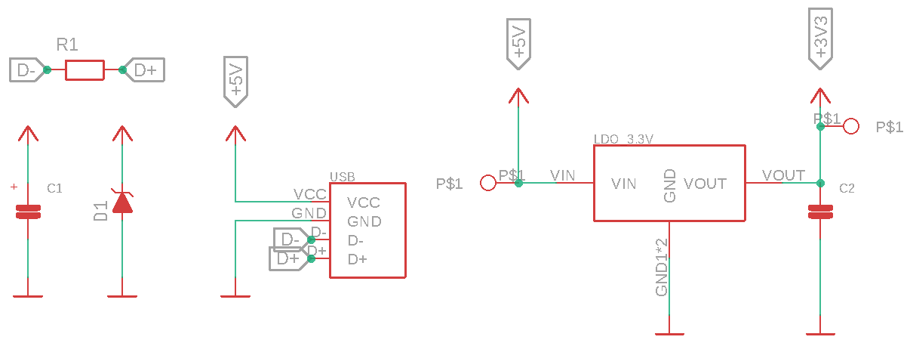
images/Schaltung-power.png
