Felix7635/BA-Dokumentation/images/Schaltung-Quartz.png

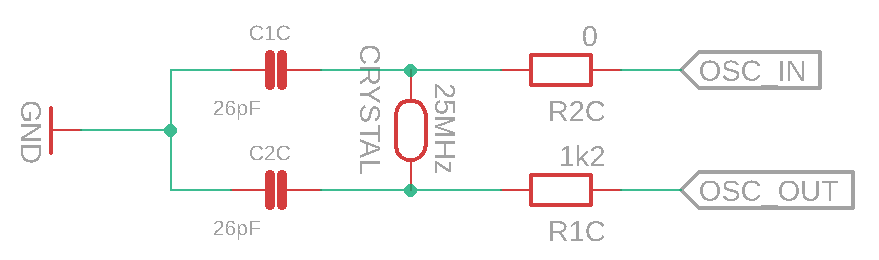
images/Schaltung-Quartz.png
