Felix7635/BA-Dokumentation/images/Schaltungsprinzip.png

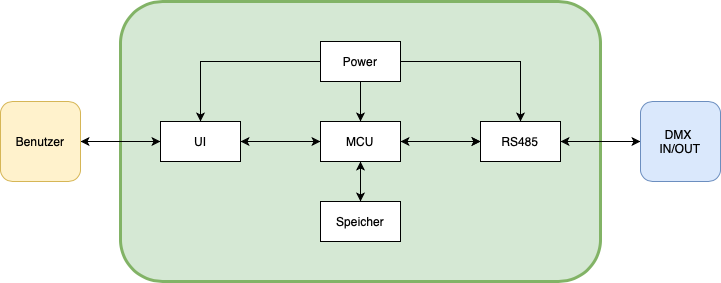
images/Schaltungsprinzip.png
