Felix7635/BA-Dokumentation/images/SchaltungsprinzipEAGLE.png

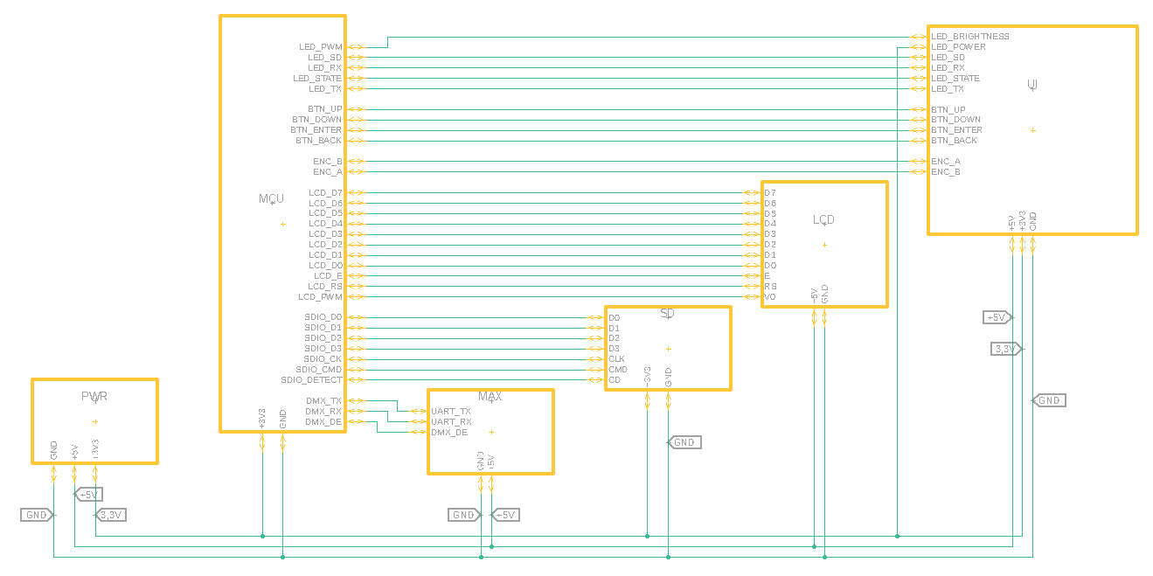
images/SchaltungsprinzipEAGLE.png
