Felix7635/BA-Dokumentation/images/STM32F446ZE_pinout.png

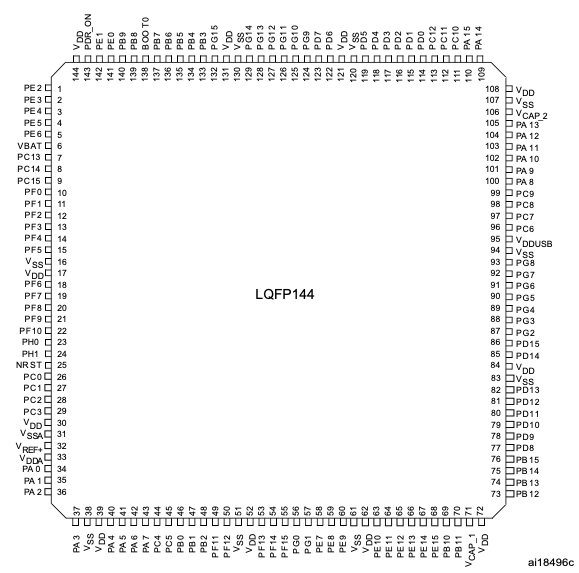
images/STM32F446ZE_pinout.png
