Felix7635/BA-Dokumentation/Anhang/3D-Modelle/LED Diffusionsscheibe.stl

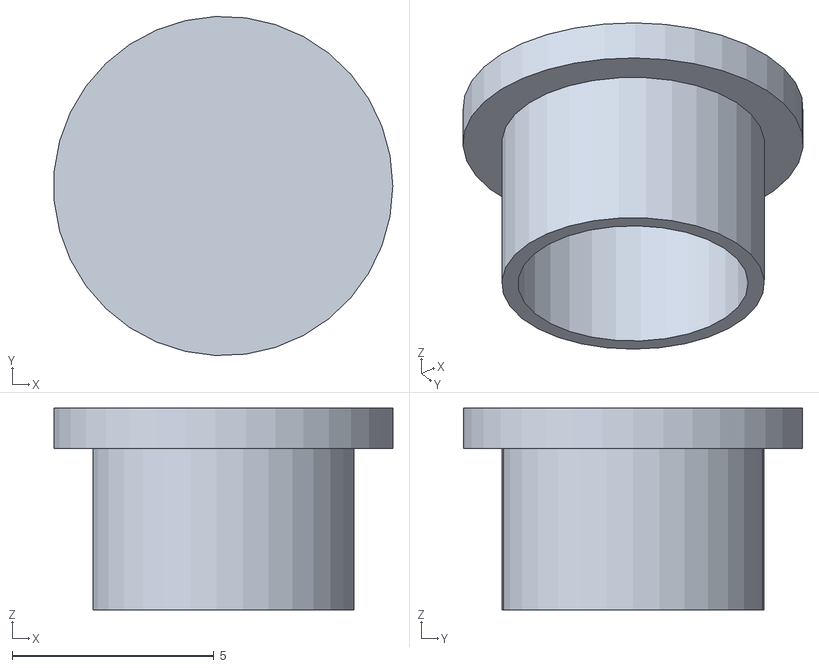
[picture p67: CAD file, 2021-09-10]
Anhang/3D-Modelle/LED Diffusionsscheibe.stl
8.38 x 8.39 x 5.00
