Felix7635/BA-Dokumentation/Anhang/3D-Modelle/Taster - Tasterfläche.stl

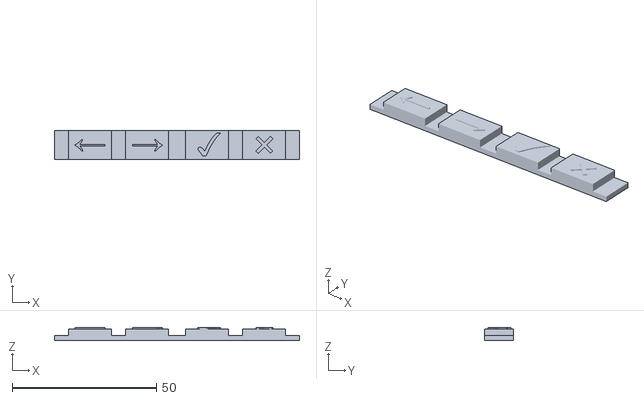
[picture p68: CAD file, 2021-09-10]
Anhang/3D-Modelle/Taster - Tasterfläche.stl
85.0 x 10.00 x 4.40
