Felix7635/BA-Dokumentation/Anhang/3D-Modelle/Encoder Aufsatz.stl

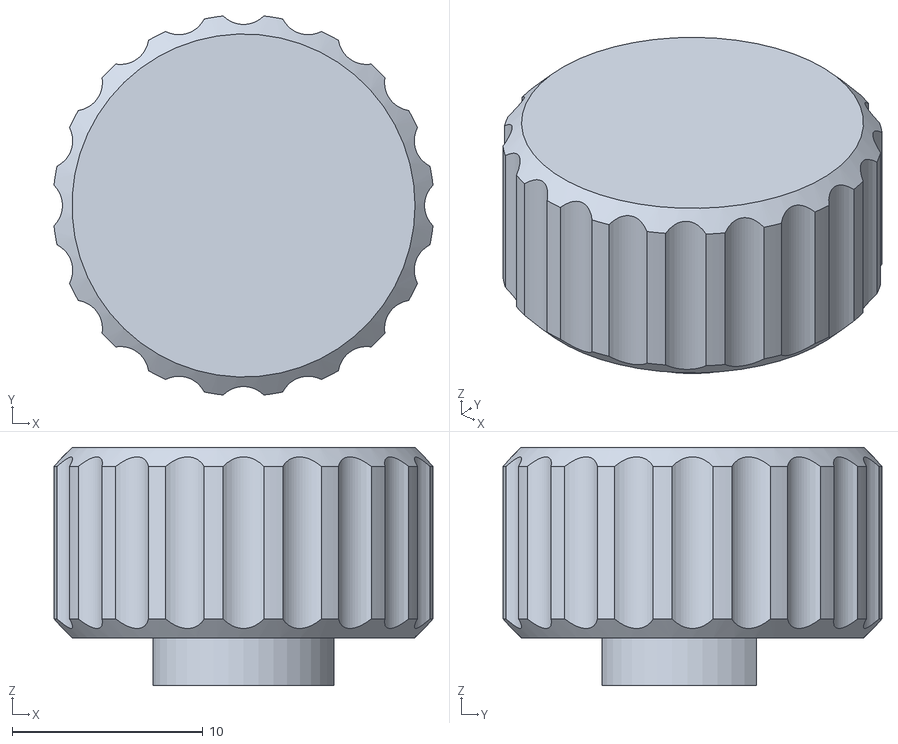
[picture p69: CAD file, 2021-09-10]
Anhang/3D-Modelle/Encoder Aufsatz.stl
19.9 x 19.9 x 12.5
