Felix7635/BA-Dokumentation/Anhang/3D-Modelle/Taster - Abdeckung.stl

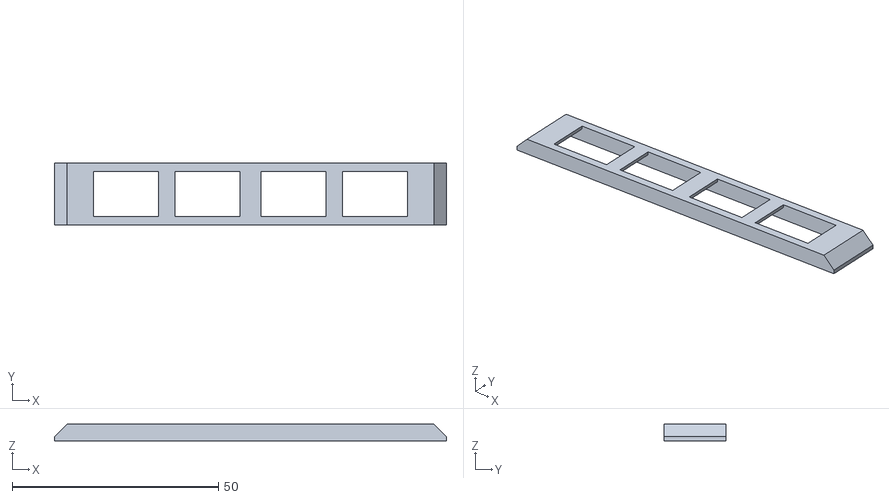
[picture p70: CAD file, 2021-09-10]
Anhang/3D-Modelle/Taster - Abdeckung.stl
95.0 x 15.0 x 4.00
