Felix7635/BA-Dokumentation/Anhang/3D-Modelle/Oberseite.stl

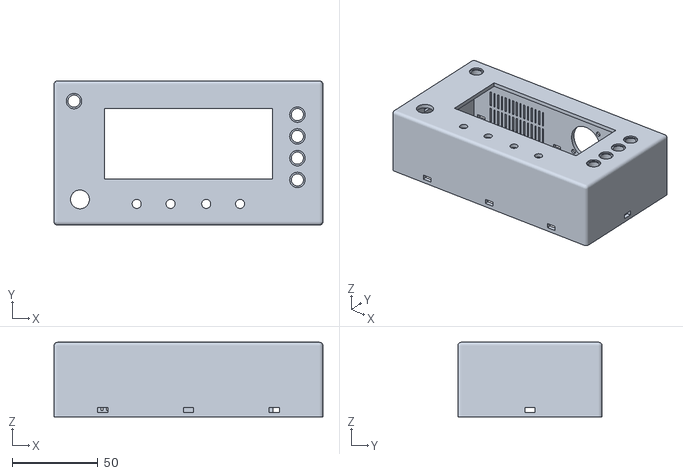
[picture p71: CAD file, 2021-09-10]
Anhang/3D-Modelle/Oberseite.stl
157.0 x 84.1 x 43.5
