Felix7635/BA-Dokumentation/Anhang/3D-Modelle/Unterseite.stl

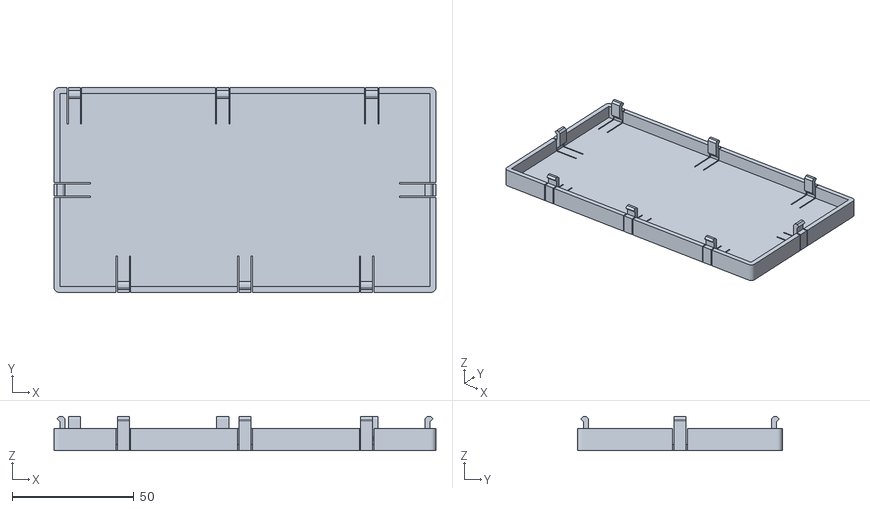
[picture p72: CAD file, 2021-09-10]
Anhang/3D-Modelle/Unterseite.stl
157.0 x 84.1 x 14.0
