Felix7635/BA-Dokumentation/Anhang/3D-Modelle/Taster - Zylinder.stl

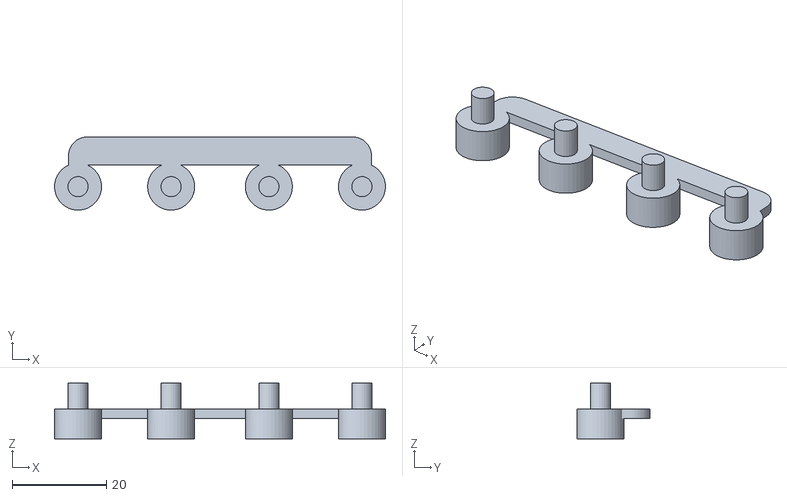
[picture p73: CAD file, 2021-09-10]
Anhang/3D-Modelle/Taster - Zylinder.stl
70.3 x 15.6 x 11.8
