Felix7635/BA-Dokumentation/(list of files, cad)

Other CAD files:
Anhang/3D-Modelle/Platine.f3d
