Felix7635/BA-Dokumentation/Anhang/EAGLE-Dateien/Projekt-Dateien/Main.brd

## EAGLE design Anhang/EAGLE-Dateien/Projekt-Dateien/Main.brd (2021-09-10)

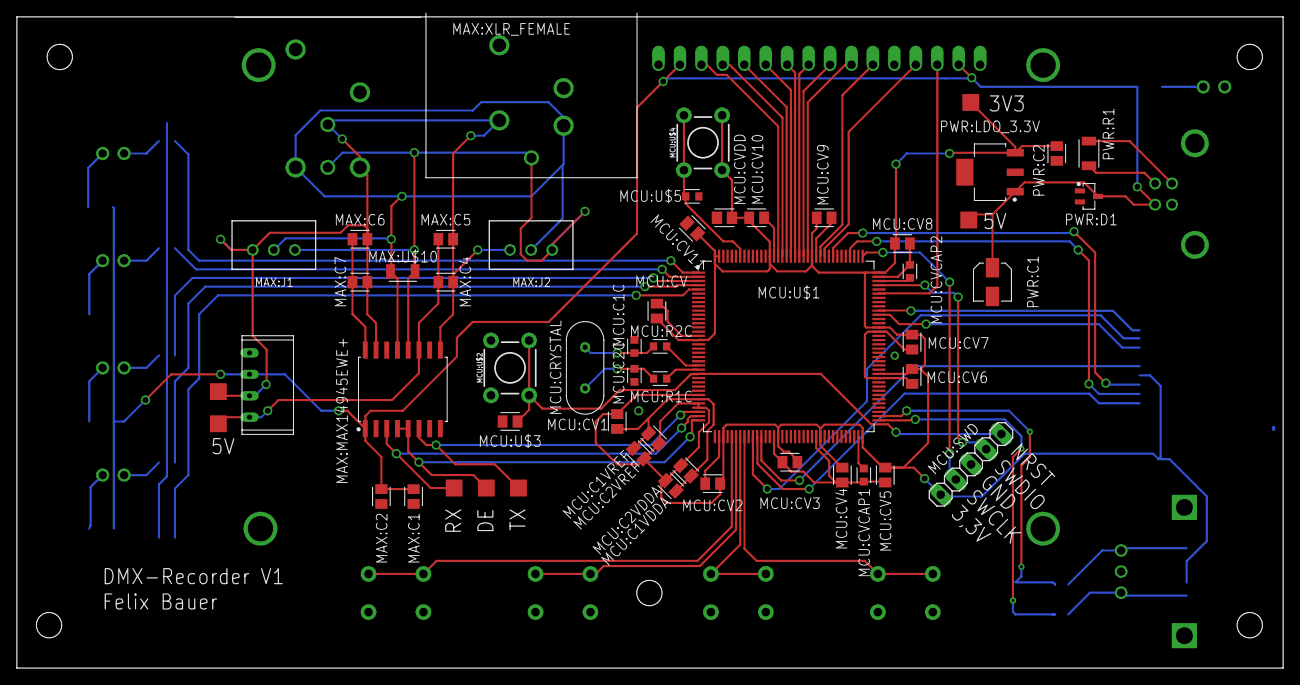
[picture p74: board Main.brd from above]

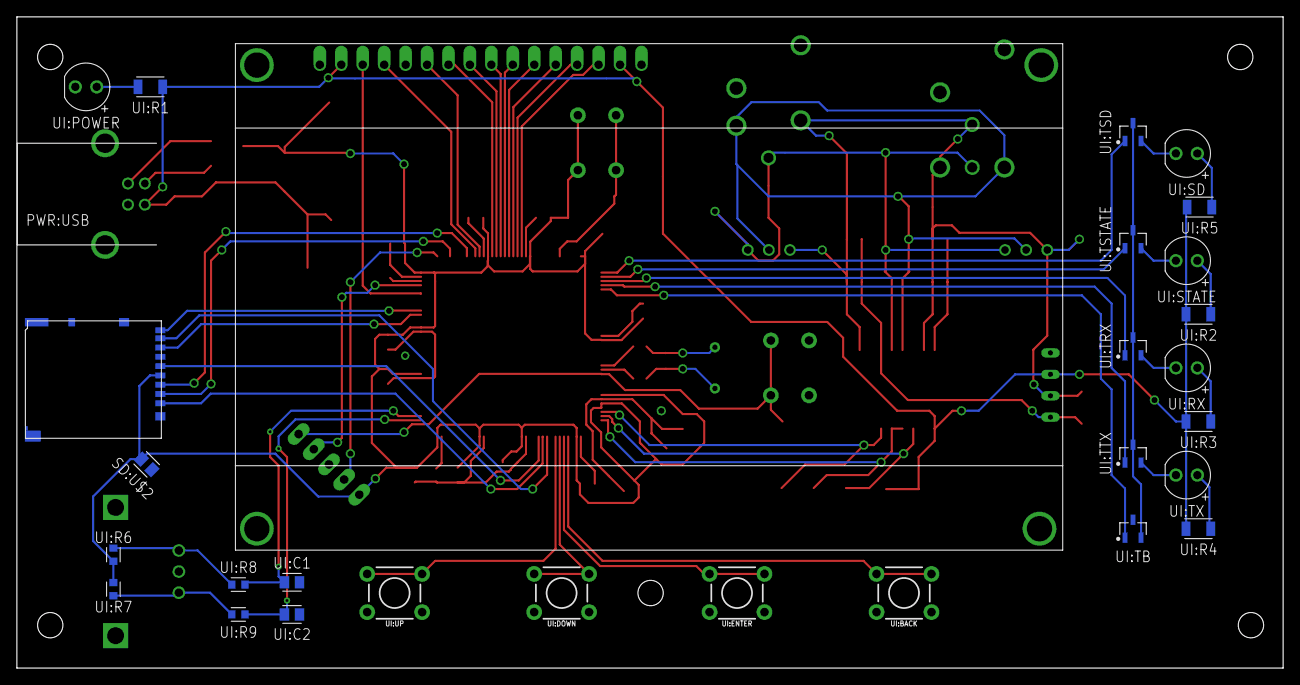
[picture p75: board Main.brd from below]

Board: 2 copper layers, 150.0 x 77.1 mm, 85 parts (30 on the bottom side), 64 nets.

Parts:
LCD:U$1: LCD_4X202004A; LCD
MAX:C1, MAX:C5, MAX:C7: 1uF; CAPC2012X100N
MAX:C2, MAX:C4, MAX:C6: 0.1uF; CAPC2012X90N
MAX:DC/DC: CONVERTER_5V/5V_DCTRACO; 5V/5V_DC_CONVERTER_TRACO
MAX:J1, MAX:J2: 3A/250V; B3B-XH-A
MAX:MAX14945EWE+: DRIVER_MAX14945EWE+; SOIC127P1032X265-16N
MAX:U$2, MAX:U$3, MAX:U$4, MAX:U$5, MAX:U$6: MESSPUNKT
MAX:U$10: 120; RESC3115X56N
MAX:XLR_FEMALE: CONNECTOR_XLR_FEMALE_NC3FAAH-0; NC3FAAH-0
MAX:XLR_MALE: CONNECTOR_XLR_MALE_NC3MBH-B; NC3MBH-B
MCU:C1C, MCU:C2C: 26pF; CAPC1608X97N
MCU:C1VDDA, MCU:C1VREF: 1uF; CAPC2012X100N
MCU:C2VDDA, MCU:C2VREF: 0.1uF; CAPC2012X90N
MCU:CRYSTAL: 25MHz; XTALRR488W43L1077T434H350B
MCU:CV, MCU:CV1, MCU:CV2, MCU:CV3, MCU:CV4, MCU:CV5, MCU:CV6, MCU:CV7, MCU:CV8, MCU:CV9, MCU:CV10, MCU:CV11: 0.1uF; CAPC2012X90N
MCU:CVCAP1, MCU:CVCAP2: 2,2uF; CAPC1608X90N
MCU:CVDD: 4,7uF; CAPC2012X140N
MCU:R1C: 1k2; RESC1608X55N
MCU:R2C: 0; RESC1608X55N
MCU:SWD: PINHD-1X5; 1X05
MCU:U$1: STM32F446ZELQFP144; QFP50P2200X2200X160-144N
MCU:U$2, MCU:U$4: BUTTON_6MM; TACTILE_SWITCH_PTH_6.0MM
MCU:U$3: 0.1uF; CAPC2012X90N
MCU:U$5: 10k; RESC1608X55N
PWR:C1: 10uF; CAPAE430X610N
PWR:C2: 1uF; CAPC2012X100N
PWR:D1: ZDIODEBZX84C6V2LT1G; SOT65P237X111-3N
PWR:LDO_3.3V: LDO_TC1262-3.3VDB; SOT230P700X180-4N
PWR:R1: 120; RESC3115X56N
PWR:U$5, PWR:U$6: MESSPUNKT
PWR:USB: CONNECTOR_USB-TYPE_B61400416121; USB-TYPE_B_CONNECTOR
SD:U$1: CONNECTOR_DM3AT-SF-PEJM5; DM3AT-SF-PEJM5
SD:U$2: 0.1uF; CAPC2012X90N
UI:BACK: BUTTON_6MM; TACTILE_SWITCH_PTH_6.0MM
UI:C1, UI:C2: 10nF; CAPC2012X145N
UI:DOWN: BUTTON_6MM; TACTILE_SWITCH_PTH_6.0MM
UI:ENCODER: ENCODER; EC12E2420404
UI:ENTER: BUTTON_6MM; TACTILE_SWITCH_PTH_6.0MM
UI:POWER: LEDBLUE; LED_5MM_BLUE
UI:R1, UI:R2, UI:R3, UI:R4, UI:R5: 120; RESC3115X56N
UI:R6, UI:R7, UI:R8, UI:R9: 10k; RESC1608X55N
UI:RX: LEDYELLOW; LED_5MM_YELLOW
UI:SD: LEDGREEN; LED_5MM_GREEN
UI:STATE: LEDRED; LED_5MM_RED
UI:TB: TRANSISTOR_NPNMMBTH10LT3G; SOT95P237X111-3N
UI:TRX: TRANSISTOR_NPNMMBTH10LT3G; SOT95P237X111-3N
UI:TSD: TRANSISTOR_NPNMMBTH10LT3G; SOT95P237X111-3N
UI:TSTATE: TRANSISTOR_NPNMMBTH10LT3G; SOT95P237X111-3N
UI:TTX: TRANSISTOR_NPNMMBTH10LT3G; SOT95P237X111-3N
UI:TX: LEDBLUE; LED_5MM_BLUE
UI:UP: BUTTON_6MM; TACTILE_SWITCH_PTH_6.0MM

Connections:
3,3V: MCU:C1VDDA.1, MCU:C1VREF.1, MCU:C2VDDA.1, MCU:C2VREF.1, MCU:CV.1, MCU:CV1.1, MCU:CV2.1, MCU:CV3.1, MCU:CV4.1, MCU:CV5.1, MCU:CV6.1, MCU:CV7.1, MCU:CV8.1, MCU:CV9.1, MCU:CV10.1, MCU:CV11.1, MCU:CVDD.1, MCU:SWD.1, MCU:U$1.17, MCU:U$1.30, MCU:U$1.32, MCU:U$1.33, MCU:U$1.39, MCU:U$1.52, MCU:U$1.62, MCU:U$1.72, MCU:U$1.84, MCU:U$1.95, MCU:U$1.108, MCU:U$1.121, MCU:U$1.131, MCU:U$1.143, MCU:U$1.144, MCU:U$4.3, MCU:U$4.4, PWR:C2.1, PWR:LDO_3.3V.VOUT, PWR:U$6.P$1, SD:U$1.VDD, SD:U$2.1, UI:R6.1, UI:R7.1
+5V: LCD:U$1.A, LCD:U$1.VDD, MAX:C1.1, MAX:C2.1, MAX:DC/DC.+VIN, MAX:MAX14945EWE+.1, PWR:C1.1, PWR:D1.3, PWR:LDO_3.3V.VIN, PWR:U$5.P$1, PWR:USB.VCC, UI:R1.1, UI:R2.1, UI:R3.1, UI:R4.1, UI:R5.1
GND: LCD:U$1.K, LCD:U$1.RW, LCD:U$1.VSS, MAX:C1.2, MAX:C2.2, MAX:DC/DC.-VIN, MAX:MAX14945EWE+.2, MAX:MAX14945EWE+.8, MCU:C1C.1, MCU:C1VDDA.2, MCU:C1VREF.2, MCU:C2C.2, MCU:C2VDDA.2, MCU:C2VREF.2, MCU:CV.2, MCU:CV1.2, MCU:CV2.2, MCU:CV3.2, MCU:CV4.2, MCU:CV5.2, MCU:CV6.2, MCU:CV7.2, MCU:CV8.2, MCU:CV9.2, MCU:CV10.2, MCU:CV11.2, MCU:CVCAP1.2, MCU:CVCAP2.2, MCU:CVDD.2, MCU:SWD.3, MCU:U$1.16, MCU:U$1.31, MCU:U$1.38, MCU:U$1.51, MCU:U$1.61, MCU:U$1.83, MCU:U$1.94, MCU:U$1.107, MCU:U$1.120, MCU:U$1.130, MCU:U$2.1, MCU:U$2.2, MCU:U$3.2, MCU:U$5.2, PWR:C1.2, PWR:C2.2, PWR:D1.1, PWR:LDO_3.3V.GND1, PWR:LDO_3.3V.GND2, PWR:USB.GND, SD:U$1.CARD_DETECTION_SWIT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, SD:U$1.VSS, SD:U$2.2, UI:BACK.1, UI:BACK.2, UI:C1.2, UI:C2.2, UI:DOWN.1, UI:DOWN.2, UI:ENCODER.C, UI:ENTER.1, UI:ENTER.2, UI:POWER.2, UI:TB.3, UI:UP.1, UI:UP.2
MAX:GNDB: MAX:C4.2, MAX:C5.2, MAX:C6.2, MAX:C7.2, MAX:DC/DC.-VOUT, MAX:J1.1, MAX:J2.1, MAX:MAX14945EWE+.9, MAX:MAX14945EWE+.15, MAX:U$2.P$1, MAX:XLR_FEMALE.1, MAX:XLR_MALE.1, MAX:XLR_MALE.G
MAX:N$1: MAX:J1.3, MAX:J2.3, MAX:MAX14945EWE+.12, MAX:U$10.1, MAX:XLR_FEMALE.3, MAX:XLR_MALE.3
MAX:N$2: MAX:J1.2, MAX:J2.2, MAX:MAX14945EWE+.13, MAX:U$10.2, MAX:XLR_FEMALE.2, MAX:XLR_MALE.2
MAX:VDDB: MAX:C6.1, MAX:C7.1, MAX:MAX14945EWE+.16
MAX:VLDO: MAX:C4.1, MAX:C5.1, MAX:DC/DC.+VOUT, MAX:MAX14945EWE+.11, MAX:U$3.P$1
MCU:BOOT0: MCU:U$1.138, MCU:U$4.1, MCU:U$4.2, MCU:U$5.1
MCU:N$2: MCU:C1C.2, MCU:CRYSTAL.1, MCU:R2C.1
MCU:N$6: MCU:C2C.1, MCU:CRYSTAL.2, MCU:R1C.1
MCU:NRST: MCU:SWD.5, MCU:U$1.25, MCU:U$2.3, MCU:U$2.4, MCU:U$3.1
MCU:OSC_IN: MCU:R2C.2, MCU:U$1.23
MCU:OSC_OUT: MCU:R1C.2, MCU:U$1.24
MCU:SWCLK: MCU:SWD.2, MCU:U$1.109
MCU:SWDIO: MCU:SWD.4, MCU:U$1.105
MCU:VCAP1: MCU:CVCAP1.1, MCU:U$1.71
MCU:VCAP2: MCU:CVCAP2.1, MCU:U$1.106
unnamed: MCU:U$1.116, SD:U$1.CMD
unnamed: MCU:U$1.48, SD:U$1.CLK
unnamed: MCU:U$1.112, SD:U$1.CD/DAT3
unnamed: MAX:MAX14945EWE+.3, MAX:U$6.P$1, MCU:U$1.35
unnamed: MAX:MAX14945EWE+.6, MAX:U$4.P$1, MCU:U$1.34
unnamed: MCU:U$1.47, SD:U$1.DAT2
unnamed: MCU:U$1.46, SD:U$1.DAT1
unnamed: MCU:U$1.98, SD:U$1.DAT0
unnamed: LCD:U$1.V0, MCU:U$1.103
unnamed: MCU:U$1.74, UI:C1.1, UI:R8.1
unnamed: LCD:U$1.E, MCU:U$1.119
unnamed: LCD:U$1.RS, MCU:U$1.118
unnamed: LCD:U$1.D0, MCU:U$1.122
unnamed: LCD:U$1.D1, MCU:U$1.123
unnamed: LCD:U$1.D4, MCU:U$1.126
unnamed: LCD:U$1.D5, MCU:U$1.127
unnamed: LCD:U$1.D6, MCU:U$1.128
unnamed: LCD:U$1.D7, MCU:U$1.129
unnamed: LCD:U$1.D2, MCU:U$1.124
unnamed: LCD:U$1.D3, MCU:U$1.125
unnamed: MCU:U$1.73, UI:C2.1, UI:R9.2
unnamed: MCU:U$1.41, UI:BACK.3, UI:BACK.4
unnamed: MCU:U$1.42, UI:ENTER.3, UI:ENTER.4
unnamed: MCU:U$1.43, UI:DOWN.3, UI:DOWN.4
unnamed: MCU:U$1.44, UI:UP.3, UI:UP.4
unnamed: MAX:MAX14945EWE+.4, MAX:MAX14945EWE+.5, MAX:U$5.P$1, MCU:U$1.36
unnamed: MCU:U$1.2, UI:TSTATE.1
unnamed: MCU:U$1.5, UI:TB.1
unnamed: MCU:U$1.4, UI:TTX.1
unnamed: MCU:U$1.3, UI:TRX.1
unnamed: MCU:U$1.1, UI:TSD.1
unnamed: MCU:U$1.99, SD:U$1.CARD_DETECTION_SWIT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
PWR:D+: PWR:R1.1, PWR:USB.D+
PWR:D-: PWR:R1.2, PWR:USB.D-
UI:N$1: UI:POWER.1, UI:R1.2
UI:N$2: UI:R2.2, UI:STATE.1
UI:N$3: UI:R3.2, UI:RX.1
UI:N$4: UI:R4.2, UI:TX.1
UI:N$7: UI:R5.2, UI:SD.1
UI:N$8: UI:TB.2, UI:TRX.3, UI:TSD.3, UI:TSTATE.3, UI:TTX.3
UI:N$9: UI:STATE.2, UI:TSTATE.2
UI:N$10: UI:RX.2, UI:TRX.2
UI:N$11: UI:TTX.2, UI:TX.2
UI:N$12: UI:SD.2, UI:TSD.2
UI:N$13: UI:ENCODER.B, UI:R6.2, UI:R8.2
UI:N$14: UI:ENCODER.A, UI:R7.2, UI:R9.1
