Felix7635/BA-Dokumentation/(commit log)

2021-06-16 Titelblatt und Inhaltsverzeichnis hinzugefügt
2021-06-17 Layout angepasst und packages hinzugefügt
2021-06-17 Selbstständigkeitserklärung und Sperrvermerk hinzugefügt
2021-06-28 Konzept mit Gegenstand und Ziel ersetzt
2021-08-06 Datenblätter der wichtigen Komponenten hinzugefügt
2021-08-15 Kapitel DMX Aufnahme und Wiedergabe hinzugefügt
    Kapitel Wiedergabe nahezu fertig
    Kapitel Aufnahme: Bisher nur Codeausschnitte eingefügt und etwas Text
2021-08-27 Abbildungen hinzugefügt
    Abbildungen für die Kapitel Einstellungen und Menü
2021-08-27 Kapitel Menu erstellt und fertiggestellt
2021-08-27 Kapitel Einstellungen erstellt und Bearbeitung begonnen
2021-08-27 Input für die Dateien Menü und Einstellungen hinzugefügt
2021-08-31 Flussdiagramm der Wiedergabefunktion zum Anhang hinzugefügt
2021-08-31 FLussdiagramm der Aufnahmefunktion hinzugefügt
2021-09-02 Kapitel DMX-Struktur hinzugefügt und Text zu Hauptkapitel hinzugefügt
2021-09-08 Tabellenbeschriftung über die Tabelle gesetzt
2021-09-10 Dateien zum Anhang hinzugefügt
    [Encoder Aufsatz.stl, LED Diffusionsscheibe.stl, Main.brd, Main.sch, Oberseite.stl, Platine.f3d, Taster - Abdeckung.stl, Taster - Tasterfläche.stl]
2021-09-12 Dateien zum CD-Anhang hinzugefügt
    [Main.brd, Main.sch]
2021-09-13 DOIs und Links zu den Quellen hinzugefügt
